hutscape/capsicum/readme.md

# Capsicum

> 🫑 Retrofit a wired doorbell to add WiFi and make it smart 🔔

Visit [hutscape.com/capsicum](https://hutscape.com/capsicum) for more details.

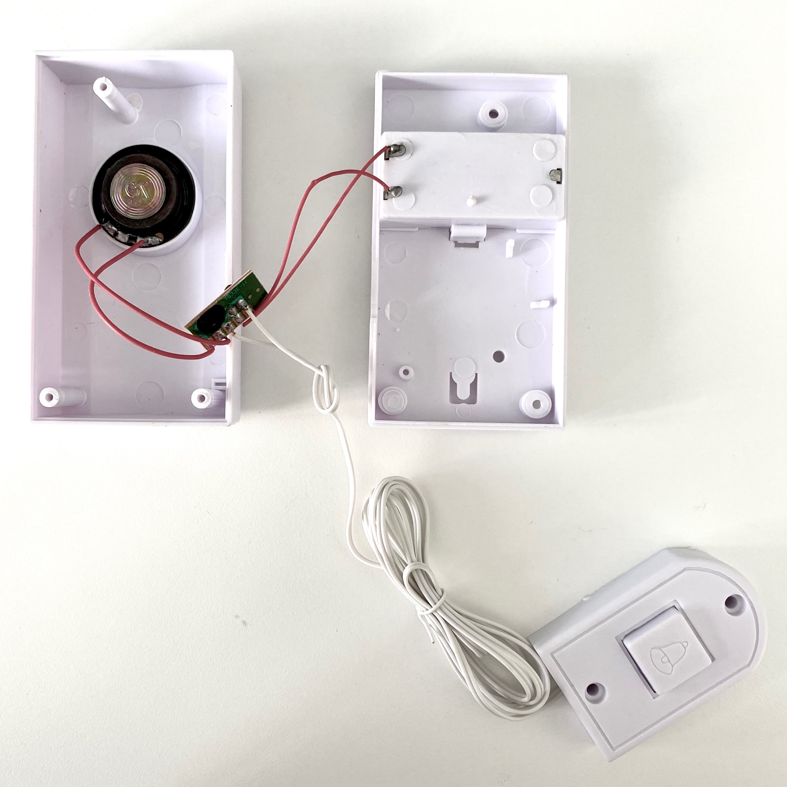
[picture p1: images/prototype/front.jpg]
