hutscape/capsicum/others.md

---
layout: others
title: Others
permalink: /others
sequence: 6

# Lessons
lessons:
  - title: V2.0
    subtitle: For next iteration
    list:
      - name: Use <a href="https://docs.kicad.org/8.0/en/pcbnew/pcbnew.html">teardrops</a> in KiCAD 8.0
      - name: Add <a href="https://youtu.be/g4m91gv-4oQ?t=1088">fudicial markers</a> for pick and place
      - name: Add more rounded corners and chamfers for <a href="https://www.pinterest.com/sayanee/product-design/">timeless product design</a> enclosures
      - name: Use a <a hreaf="https://github.com/makermoekoe/Picoclick-C3/blob/main/pcb/Picoclick_C3T/picoclick_c3t_v1_bom.csv#L18">single RGB LED</a> for status indication
      - name: Add <a href="https://forum.kicad.info/t/understanding-multi-sheet-schematics/42922/2">multi sheet schematics</a> for better readability
      - name: Add component images and parameter graphs<a href="https://github.com/EPFLXplore/XRE_LeggedRobot_HW/blob/master/amulet_controller/Schematic/amulet_controller.pdf"</a> in schematics
      - name: Use <a href="https://github.com/arduino-libraries/Arduino_ESP32_OTA">OTA updates</a> for firmware
      - name: Use a better quality <a href="https://www.digikey.com/en/products/detail/nidec-components-corporation/CL-SB-22A-11T/3507836">slide switch DPDT</a> for <a href="https://www.nordicsemi.com/Products/Development-hardware/Power-Profiler-Kit-2/Download#infotabs">better tactile feedback</a>

  - title: Lessons learnt
    subtitle: Improvements for the next version
    list:
      - name: <strong>Case</strong> - Make the text height bigger for LEDs and ON/OFF power switch
      - name: <strong>Case</strong> - Add more chamfers and rounded corners for a better aesthetic
      - name: <strong>Teeth and groves</strong> - Make the teeth thicker for better strength
      - name: <strong>Teeth and groves</strong> - Add holder in the teeth to that the top and bottom case do not slide
      - name: <strong>Teeth and grooves</strong> - Include visual cues on the exterior for finger placement
      - name: <strong>Battery</strong> - Use flat LiPo battery for a compact design
      - name: <strong>PCB</strong> - Add silkscreen pin labels for all connectors that extend outside the PCB E.g. pin headers or USB-C

# References
similar:
  - name: Adafruit QT Py ESP32-C3 WiFi Dev Board
    url: https://www.adafruit.com/product/5405
    type: maker
    year: 2022
    components:
      - type: module
        name: ESP32-C3H4 (no antenna)
      - type: LDO
        name: AP2112K-3.3
      - type: connector
        name: USB-C
  - name: Seeed Studio ESP32-C3 XIAO board
    url: https://files.seeedstudio.com/wiki/XIAO_WiFi/Resources/Seeeduino-XIAO-ESP32C3-SCH.pdf
    type: maker
    year: 2022
    components:
      - type: module
        name: ESP32-C3FN4 (no on-board antenna)
      - type: LDO
        name: XC6204B33
      - type: connector
        name: USB-C
  - name: Olimex ESP32-C3-DevKit-Lipo
    url: https://www.olimex.com/Products/IoT/ESP32-C3/ESP32-C3-DevKit-Lipo/open-source-hardware
    type: maker
    year: 2022
    components:
      - type: module
        name: ESP32-C3-MINI-1-N4 (with PCB antenna and 4MB flash)
      - type: DC-DC regulator
        name: SY8089AAAC
      - type: linear charger for lithium-ion batteries
        name: BL4054B
      - type: connector
        name: USB-C
      - type: battery
        name: LiPo
  - name: LilyGO T-OI Plus
    url: https://www.lilygo.cc/products/t-oi-plus
    type: maker
    year: 2021
    components:
      - type: module
        name: ESP32-C3
      - type: flash
        name: W25Q32FVSS (external 32MB flash)
      - type: LDO
        name: ME6211
      - type: linear charger for lithium-ion batteries
        name: TP4054
      - type: battery
        name: 16340
      - type: connector
        name: USB-C
  - name: Espressif ESP32-C3 DevKit M-1
    url: https://dl.espressif.com/dl/schematics/SCH_ESP32-C3-DEVKITM-1_V1_20200915A.pdf
    type: maker
    year: 2021
    components:
      - type: module
        name: ESP32-C3
      - type: connector
        name: micro USB
  - name: MakerMoeKoe picoclick C3
    url: https://github.com/makermoekoe/Picoclick-C3/blob/main/pcb/Picoclick_C3/picoclick_c3_v1.1.pdf
    type: maker
    year: 2021
    components:
      - type: module
        name: ESP32-C3
      - type: connector
        name: USB-C
  - name: DIY Wireless Smart Doorbell by The Hook Up
    url: https://github.com/thehookup/Wireless_MQTT_Doorbell
    type: maker
    year: 2018
    components:
      - type: module
        name: nodeMCU
      - type: software stack
        name: Node-Red, MQTT
  - name: SS4H-SD Smart Doorbell
    url: https://smartsolutions4home.com/ss4h-sd-smart-doorbell/
    type: maker
    year: 2020
    components:
      - type: module
        name: ESP32
      - type: software stack
        name: ESPHome, Home Assistant
  - name: Doorbell WiFi Upgrade
    url: https://www.youtube.com/watch?v=NP7_cPEDocI
    type: maker
    year: 2021
    components:
      - type: module
        name: ESP8266
      - type: software stack
        name: Node-Red, WLED
  - name: DIY Doorbell Circuit for Homes
    url: https://www.circuits-diy.com/diy-doorbell-circuit-for-homes-electronics-projects/
    type: maker
    year: 2022
    components:
      - type: melody generator IC
        name: UM66
      - type: speaker
        name: 8ohms speaker
  - name: Prototype to PCB by Using Autodesk Circuits
    url: https://www.instructables.com/Prototype-to-PCB-by-Using-Autodesk-Circuits/
    type: maker
    year: 2016
    components:
      - type: melody generator IC
        name: NE555N
      - type: speaker
        name: 8ohms speaker
  - name:  DIY Musical Doorbell Circuit using UM66T
    url: https://circuitdigest.com/electronic-circuits/diy-musical-doorbell-circuit-using-um66-ic
    type: maker
    year: 2021
    components:
      - type: speaker
        name: 8ohms speaker
      - type: melody generator IC
        name: UM66T
  - name: Electronic ding dong doorbell
    url: https://www.pcbway.com/project/shareproject/Electronic_ding_dong_doorbell.html
    type: maker
    year: 2020
    components:
      - type: speaker
        name: 8ohms speaker
      - type: melody generator IC
        name: IC555

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

  - topic: Snap fit 3D printed enclosure
    list:
      - name: Adafruit Feather Scorpio Snap Fit Case
        url: https://learn.adafruit.com/feather-scorpio-snap-fit-case/overview
      - name: No-screw PCB placement in a snap fit 3D printed case
        url: https://www.youtube.com/watch?v=m_-d8xcSDQs
      - name: Simple SNAP FIT ENCLOSURE Design
        url: https://www.youtube.com/watch?v=EPpr1nilC14

  - topic: ESP32
    list:
      - name: Espressif product comparison
        url: https://products.espressif.com/#/product-comparison

  - topic: Low Power battery measurement circuit
    list:
      - name: Battery Voltage Monitoring
        url: https://electronics.stackexchange.com/questions/424627/battery-voltage-monitoring
      - name: Zero-power battery measurement
        url: https://jeelabs.org/2013/05/17/zero-powe-battery-measurement/index.html
      - name: Low Power battery measurement switch?
        url: https://forum.arduino.cc/t/low-power-battery-measurement-switch/1171203

# Schedule
design_start: '2023-10-01'
design_end: '2024-02-29'
manufacturing_start: '2024-03-01'
manufacturing_end: '2024-03-21'
manufacturing_end: '2024-03-21'
integration_start: '2024-03-22'
progress:
  - month: March 2024
    details: Send for manufacturing and assembly of 2 prototypes. This phase includes PCB manufacturing, component procurement, pick and place, 3D printing the cases.
  - month: December 2023
    details: Completing the schematics with footprints, MPN and availability of assembly parts.
---
