hutscape/capsicum/_code/only-breadboard.md

---
layout: code
title: Only breadboard with PSU
description: Test the retrofit of the doorbell with only the breadboard and a PSU
difficulty: easy
features:
  - retrofit
  - push
  - button
  - power supply unit
  - psu
  - bell
has_code: false
images:
  prototype: only-breadboard-prototype.jpeg
  schematic: only-breadboard-schematic.png
---

This example shows how to test the retrofit of the doorbell with only the breadboard and a PSU providing 3.3V. The breadboard is used to connect the push button and the retrofit board. The PSU is used to provide power to the retrofit board.
