hutscape/capsicum/images/case/case-3dprint-3.jpg

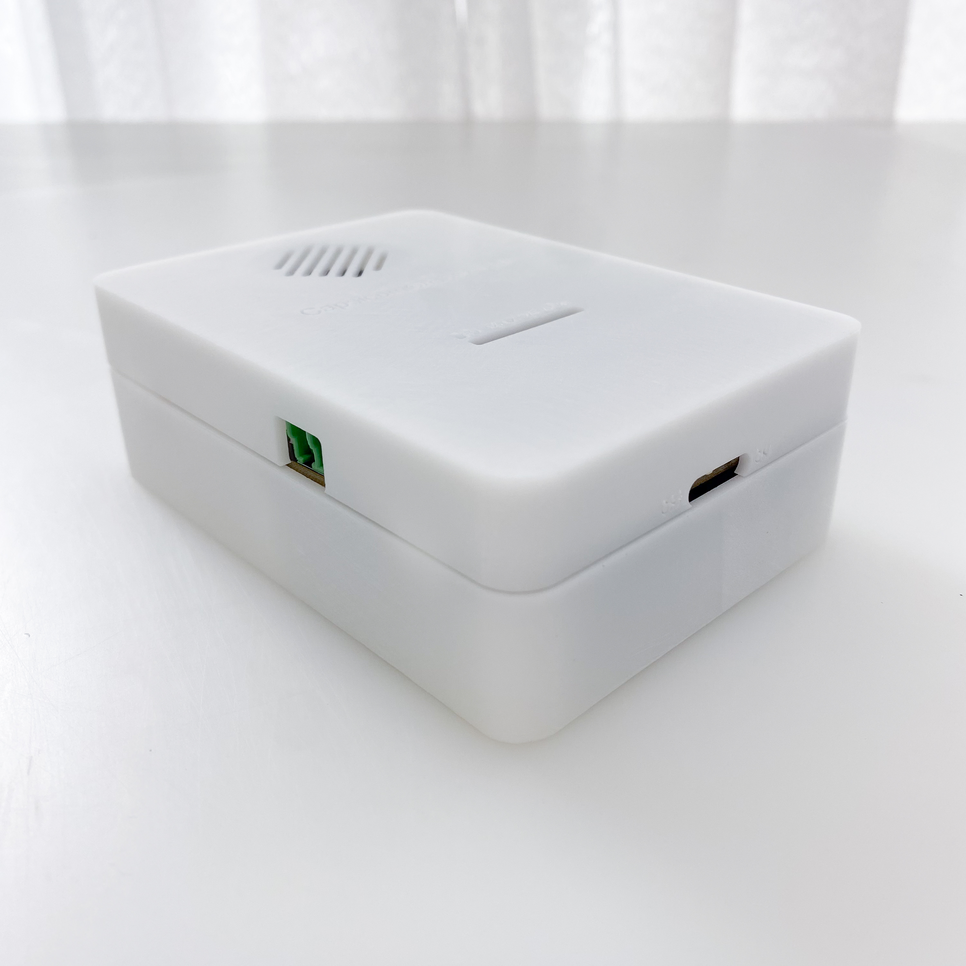
images/case/case-3dprint-3.jpg
