hutscape/capsicum/images/case/case-back.png

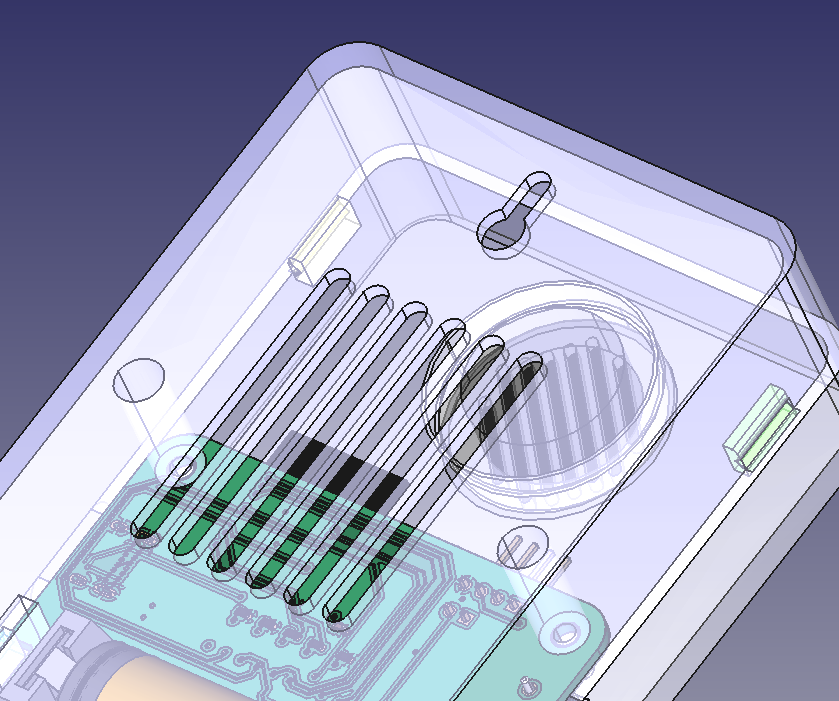
images/case/case-back.png
