hutscape/capsicum/images/case/case-details-1.png

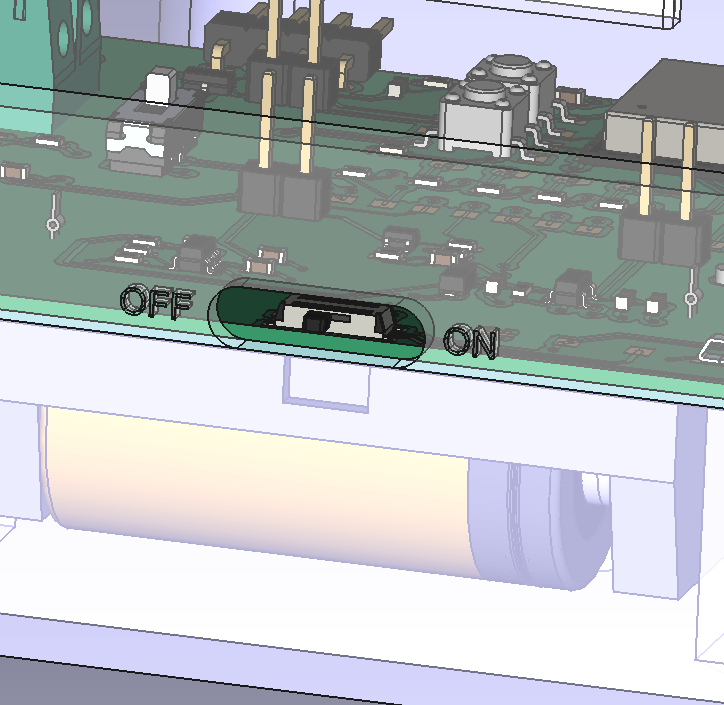
images/case/case-details-1.png
