hutscape/capsicum/images/case/case-details-2.png

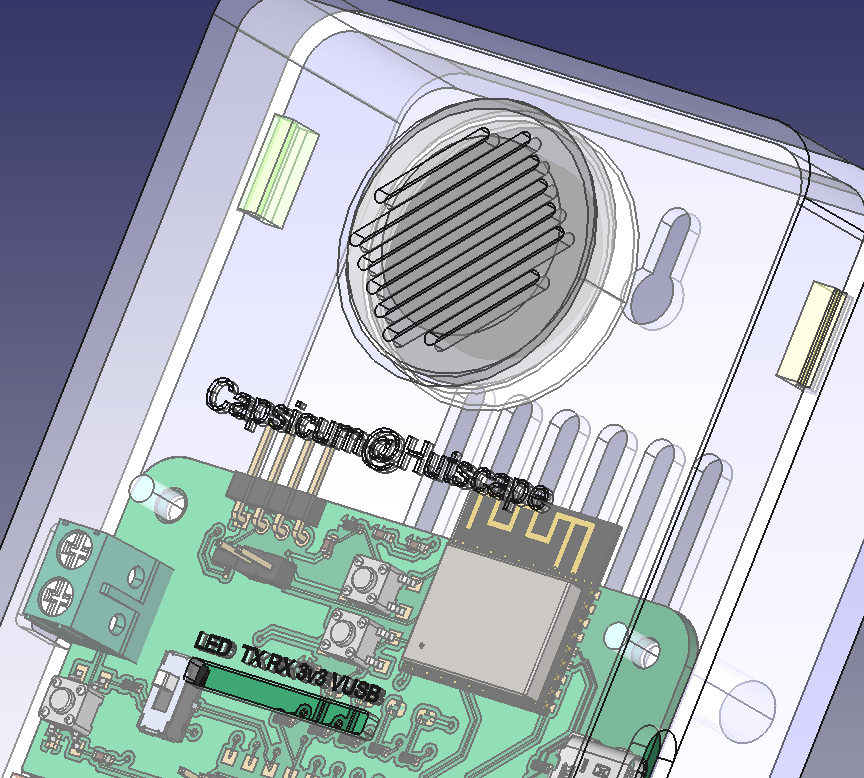
images/case/case-details-2.png
