hutscape/capsicum/images/case/case-electronics.png

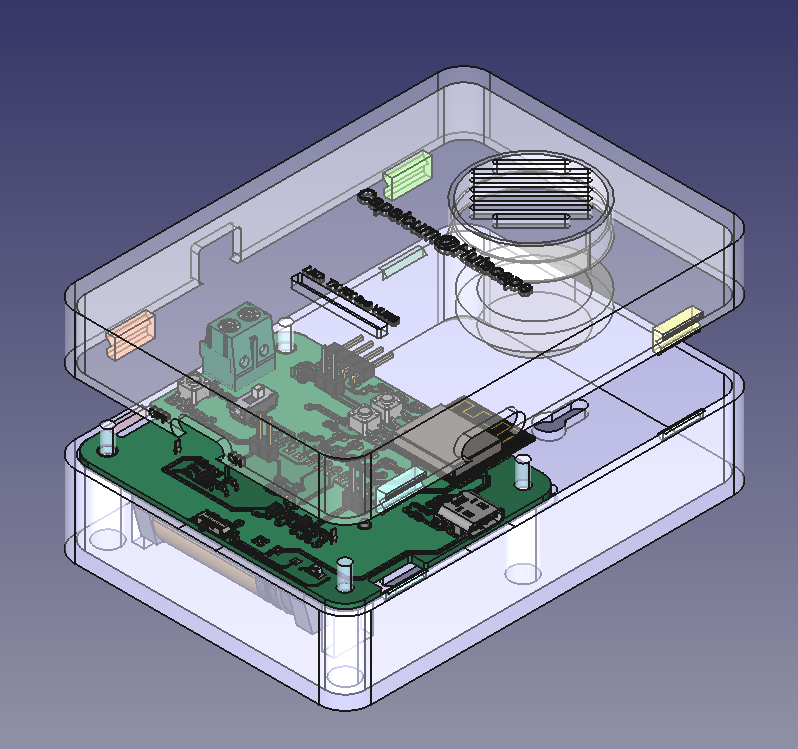
images/case/case-electronics.png
