hutscape/capsicum/images/case/case-front.png

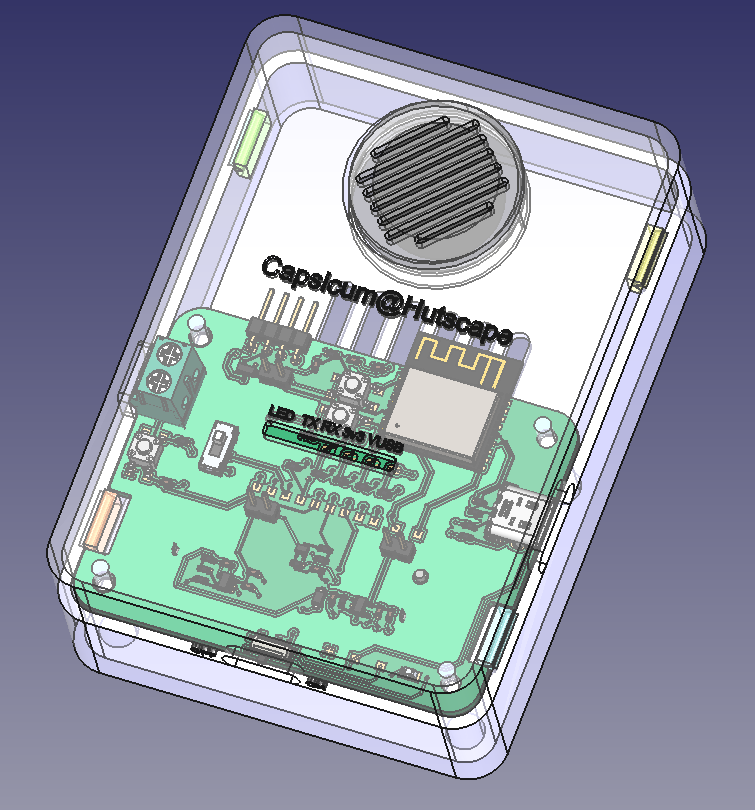
images/case/case-front.png
