hutscape/capsicum/images/case/case.png

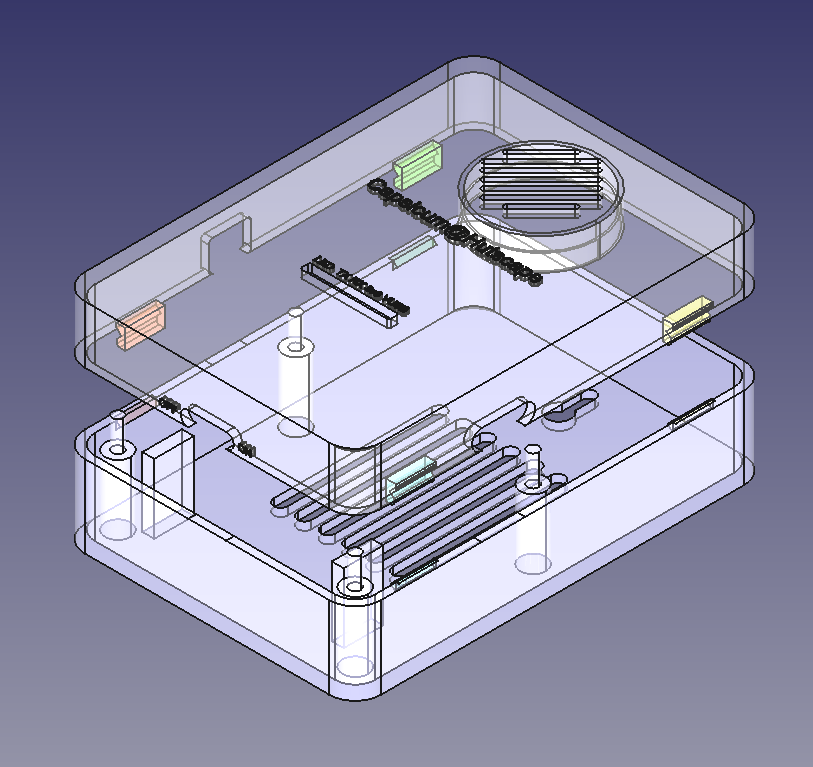
images/case/case.png
