hutscape/capsicum/images/code/access-point-console.png

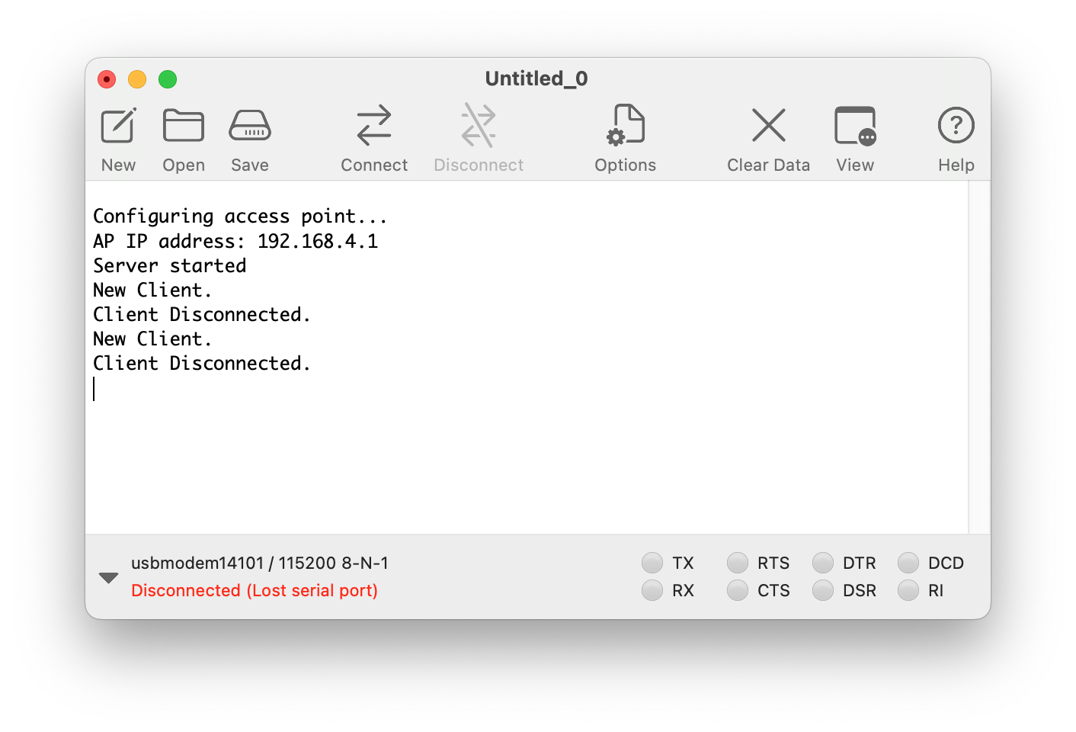
images/code/access-point-console.png
