hutscape/capsicum/images/code/access-point-prototype.jpg

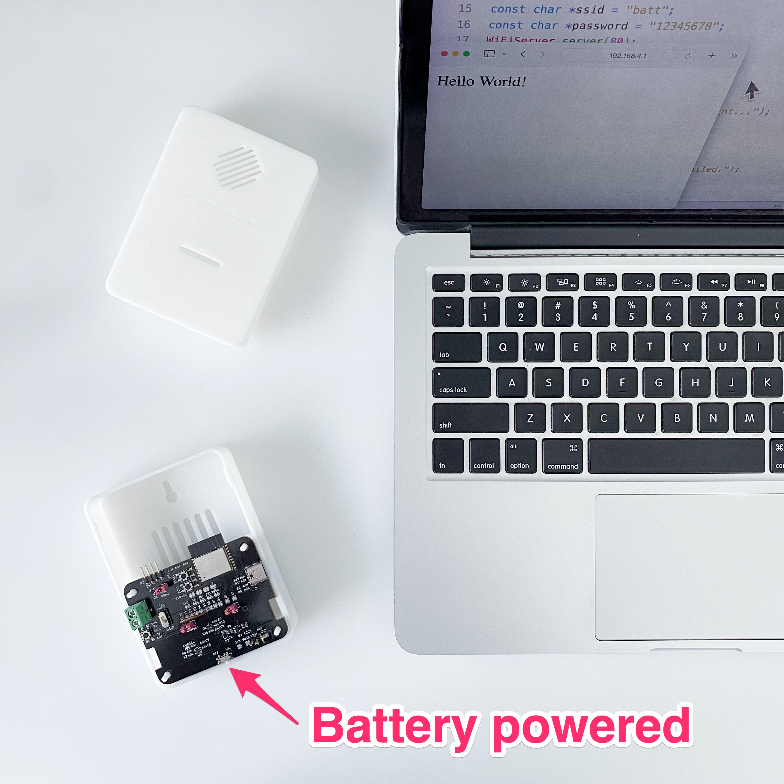
images/code/access-point-prototype.jpg
