hutscape/capsicum/images/code/analog-battery-adc-console.png

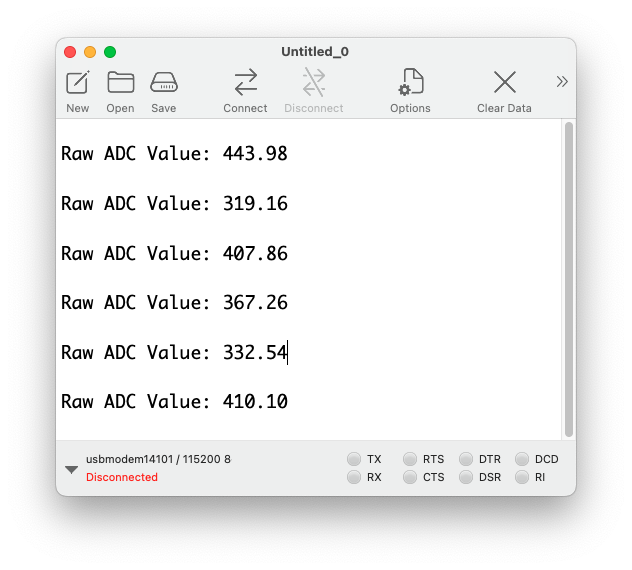
images/code/analog-battery-adc-console.png
