hutscape/capsicum/images/code/analog-battery-adc-prototype.jpeg

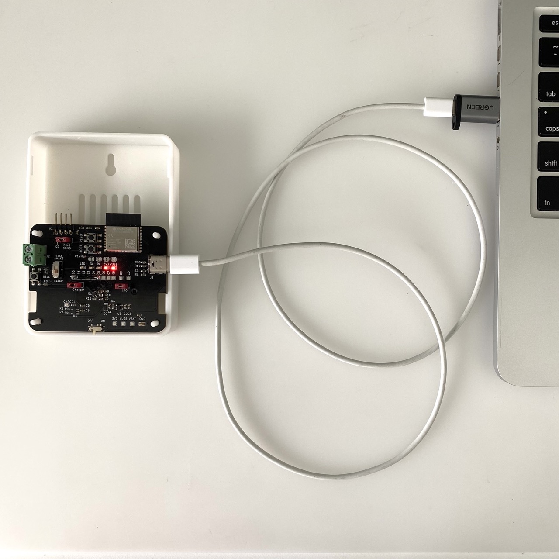
images/code/analog-battery-adc-prototype.jpeg
