hutscape/capsicum/images/code/blinky-console.png

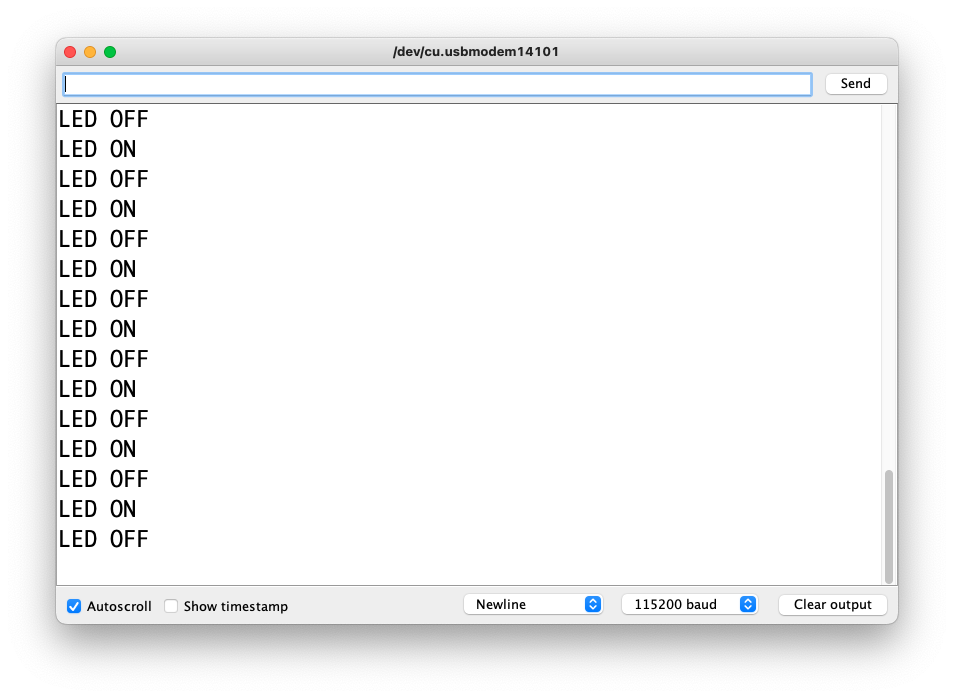
images/code/blinky-console.png
