hutscape/capsicum/images/code/blinky-prototype.jpg

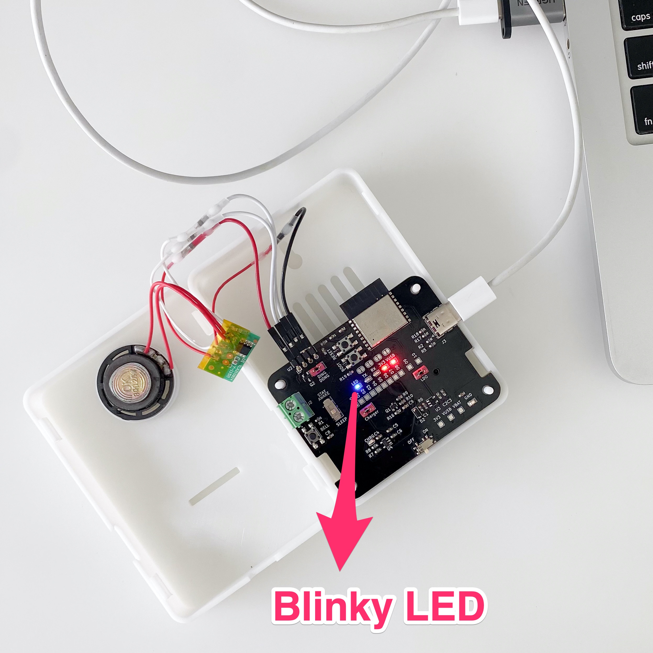
images/code/blinky-prototype.jpg
