hutscape/capsicum/images/code/demo-breadboard-console.png

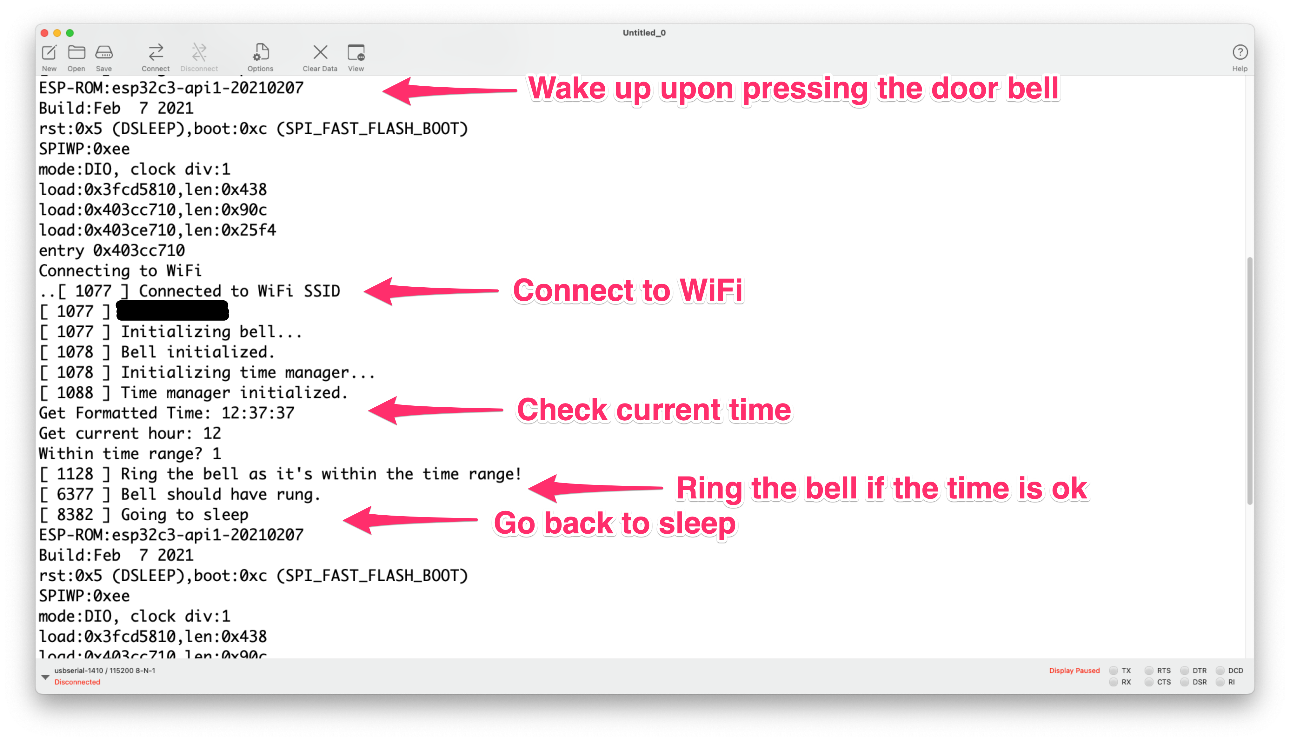
images/code/demo-breadboard-console.png
