hutscape/capsicum/images/code/demo-breadboard-schematic.png

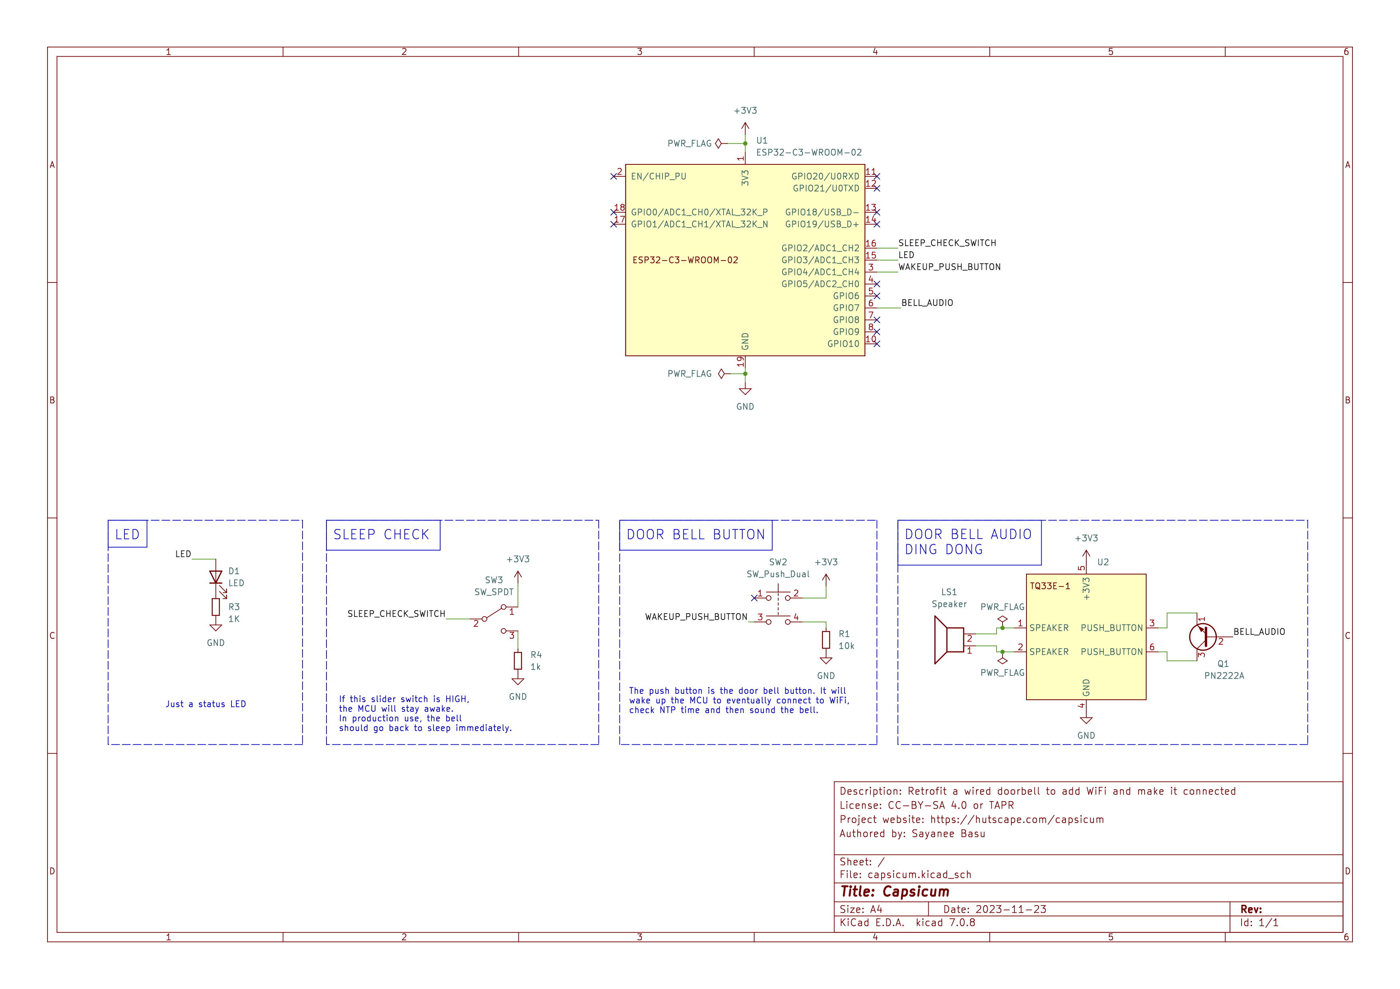
images/code/demo-breadboard-schematic.png
