hutscape/capsicum/images/code/demo-prototype.jpg

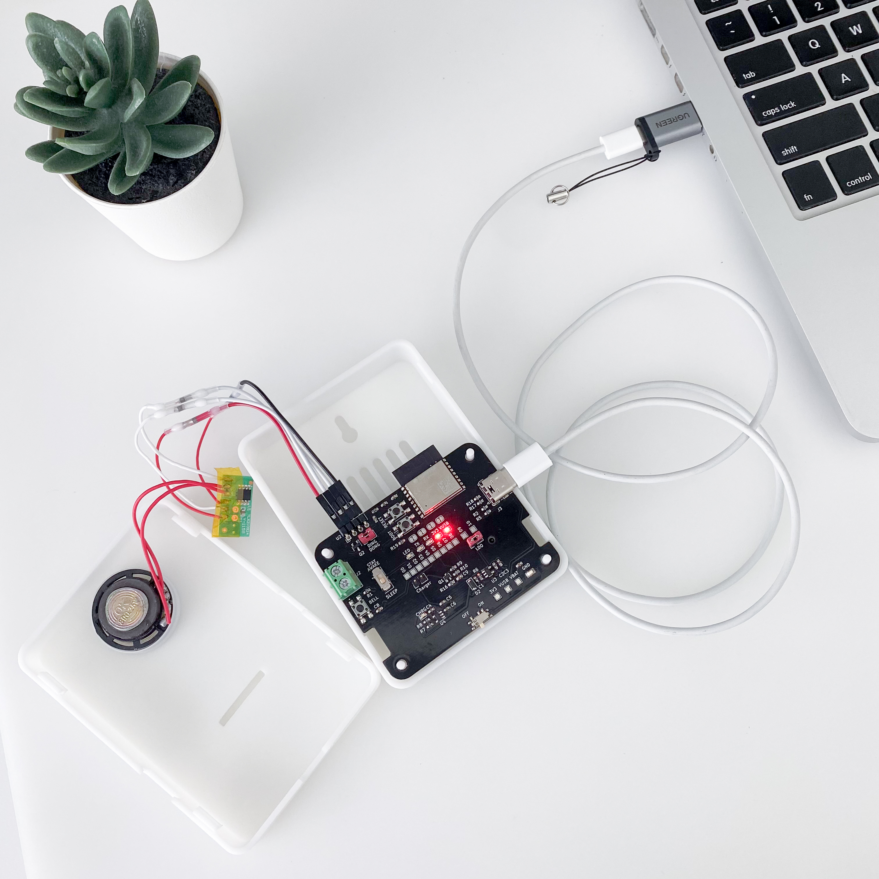
images/code/demo-prototype.jpg
