hutscape/capsicum/images/code/minimum-breadboard-prototype.jpg

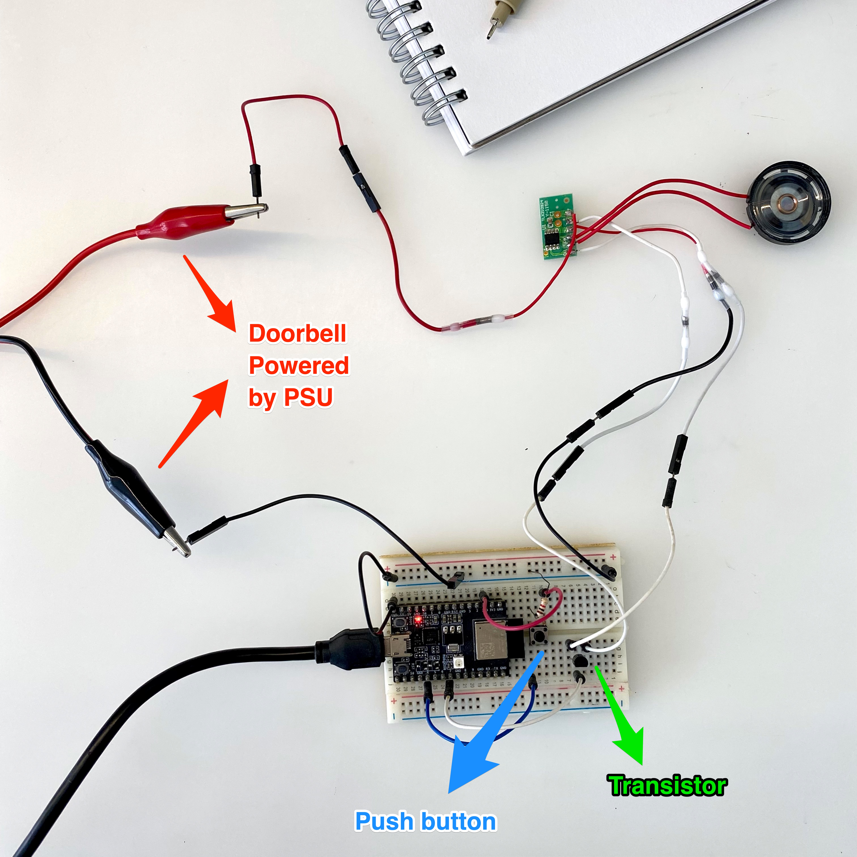
images/code/minimum-breadboard-prototype.jpg
