hutscape/capsicum/images/code/minimum-breadboard-schematic.png

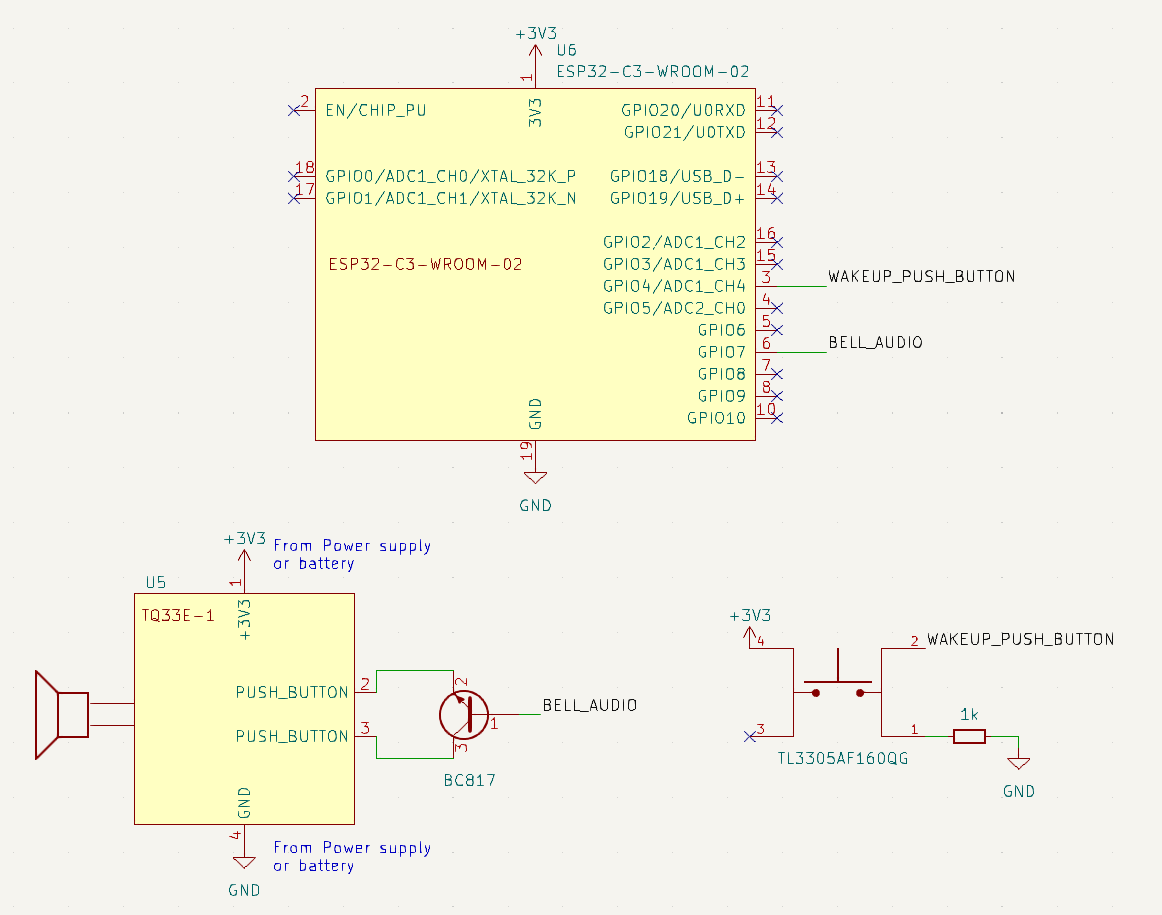
images/code/minimum-breadboard-schematic.png
