hutscape/capsicum/images/code/minumum-breadboard-console.png

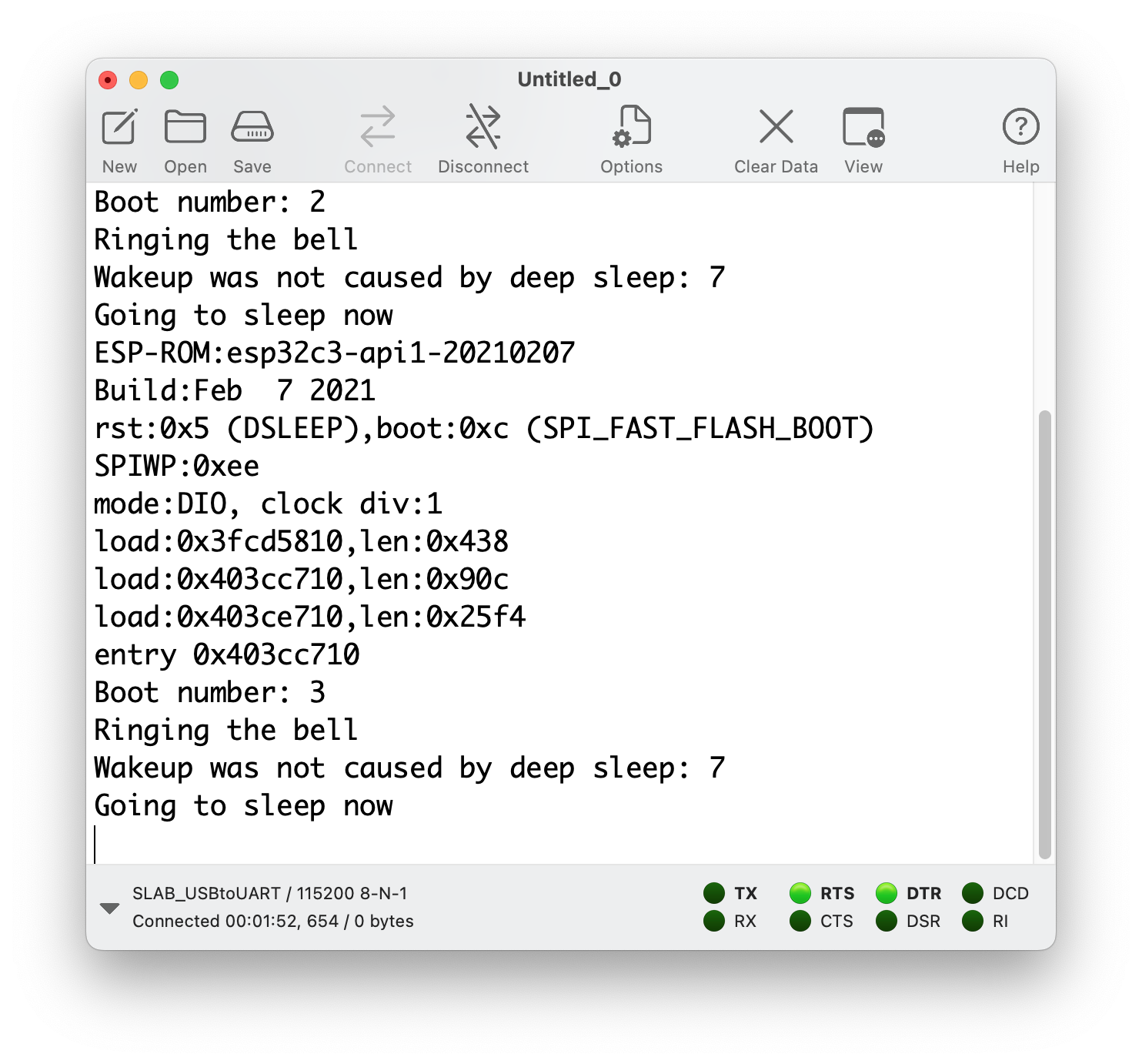
images/code/minumum-breadboard-console.png
