hutscape/capsicum/images/code/only-breadboard-prototype.jpeg

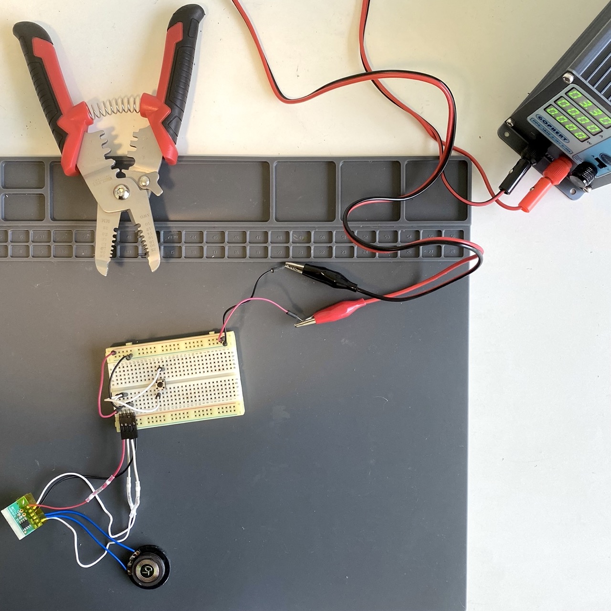
images/code/only-breadboard-prototype.jpeg
