hutscape/capsicum/images/code/only-breadboard-schematic.png

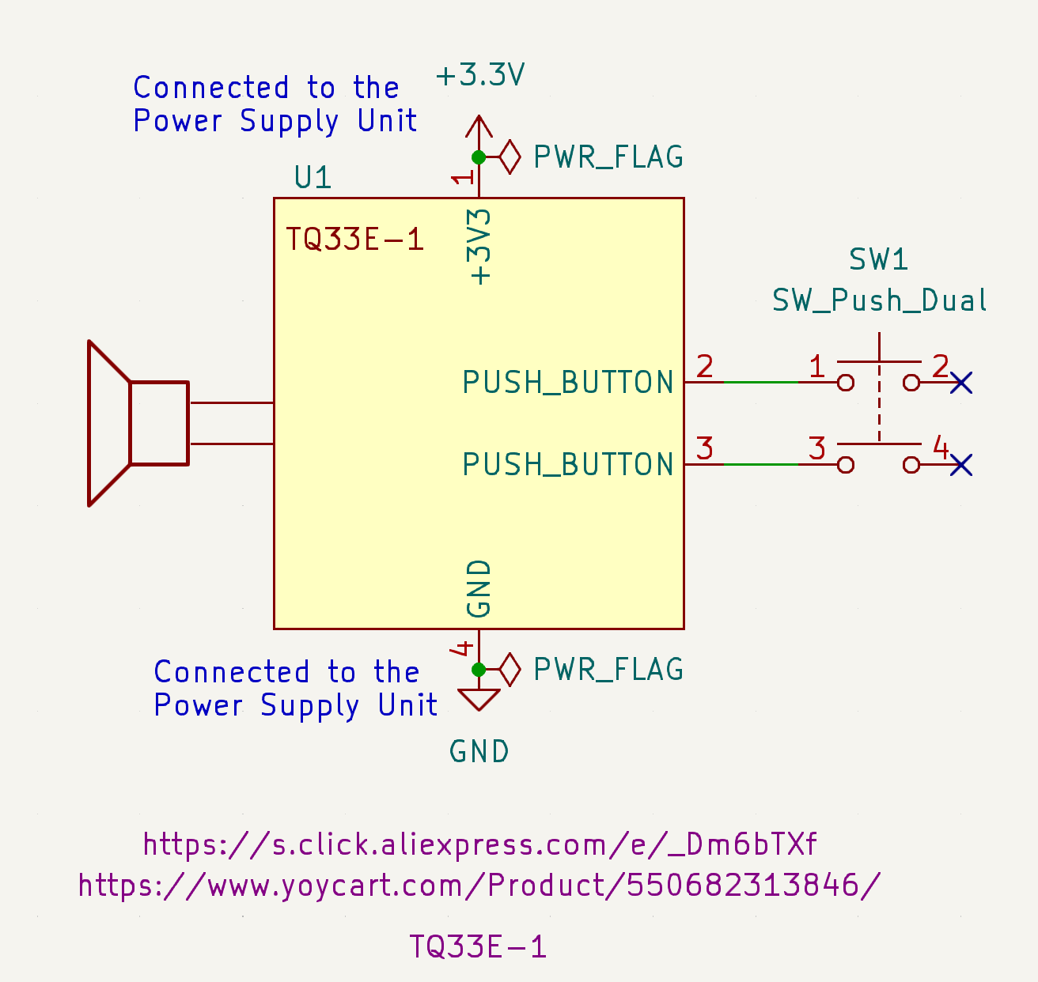
images/code/only-breadboard-schematic.png
