hutscape/capsicum/images/code/schematic.png

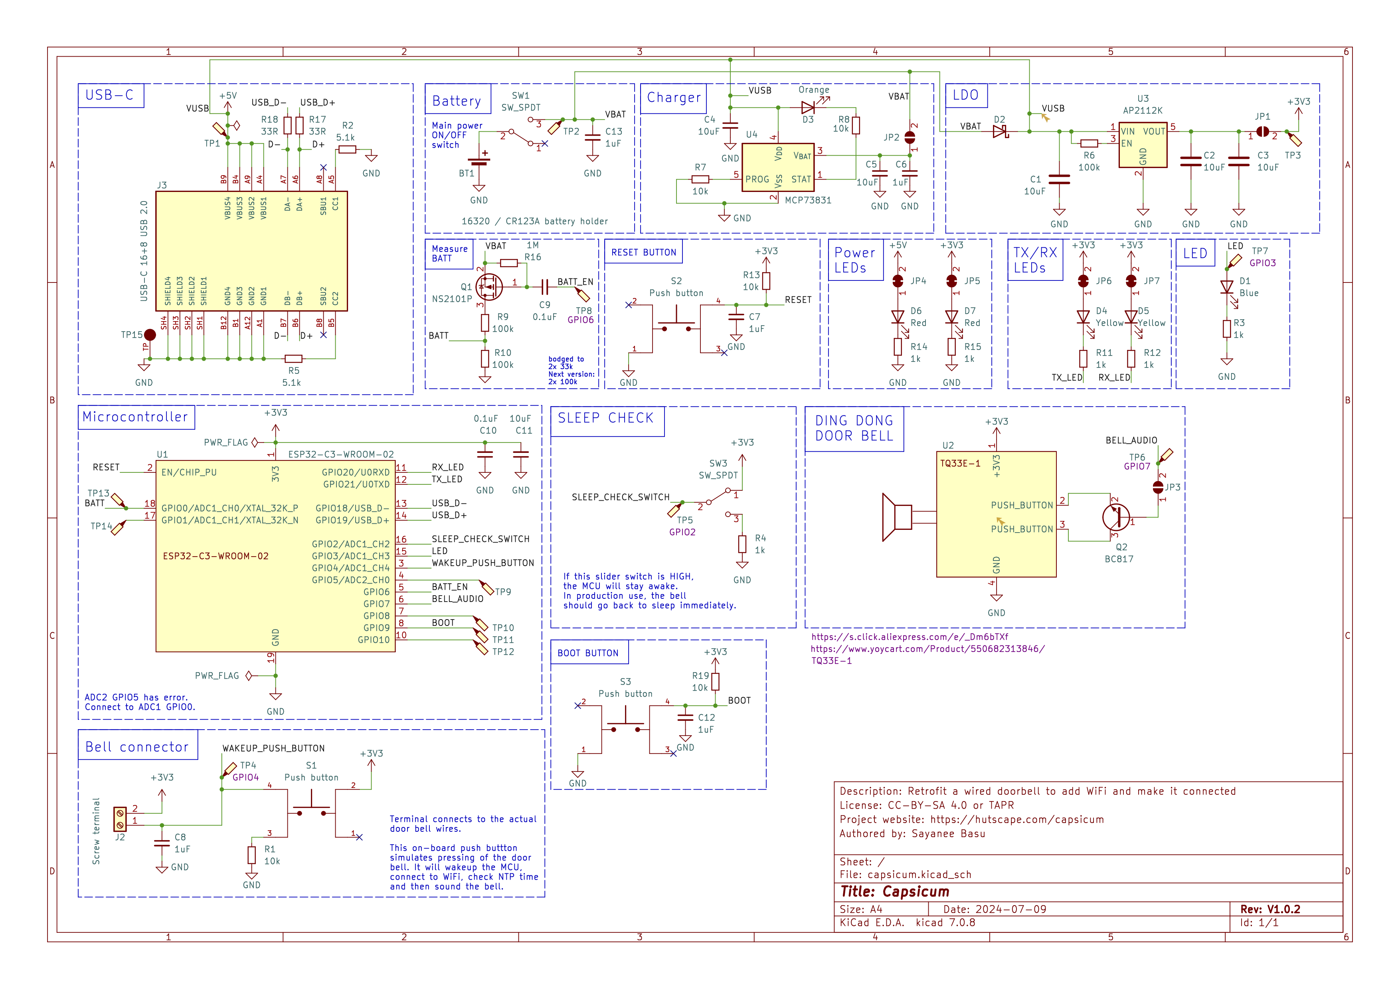
images/code/schematic.png
