hutscape/capsicum/images/design/subsystem.png

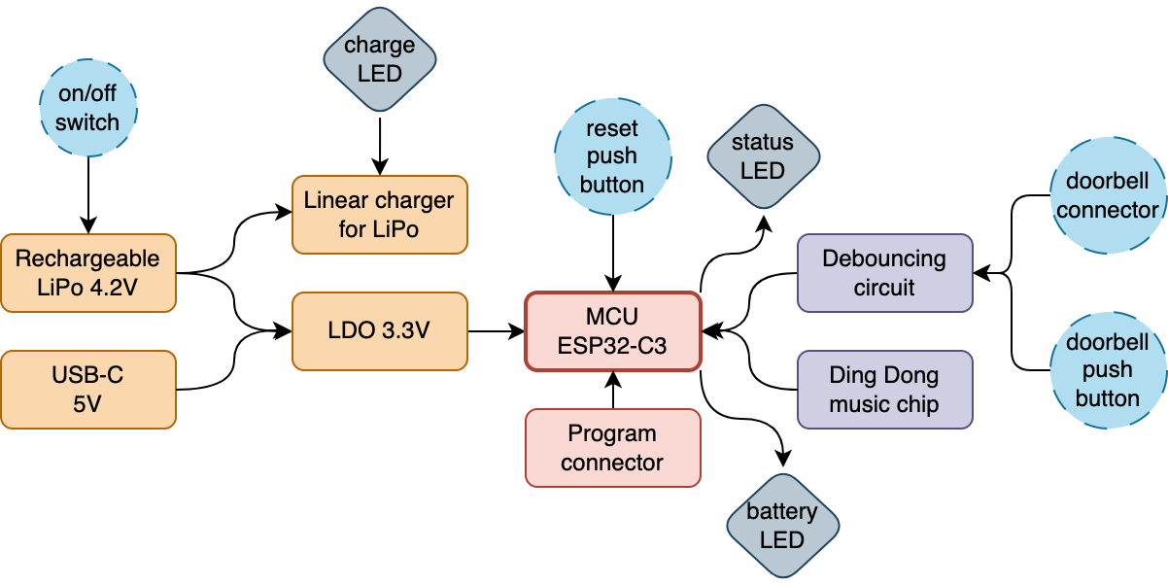
images/design/subsystem.png
