hutscape/capsicum/images/pcb/3dview-bottom.png

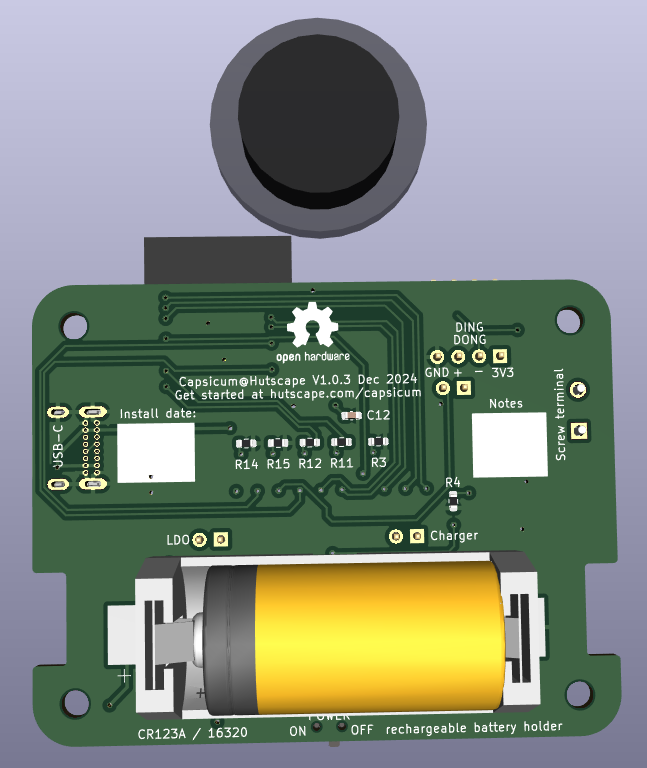
images/pcb/3dview-bottom.png
