hutscape/capsicum/images/pcb/3dview-top.png

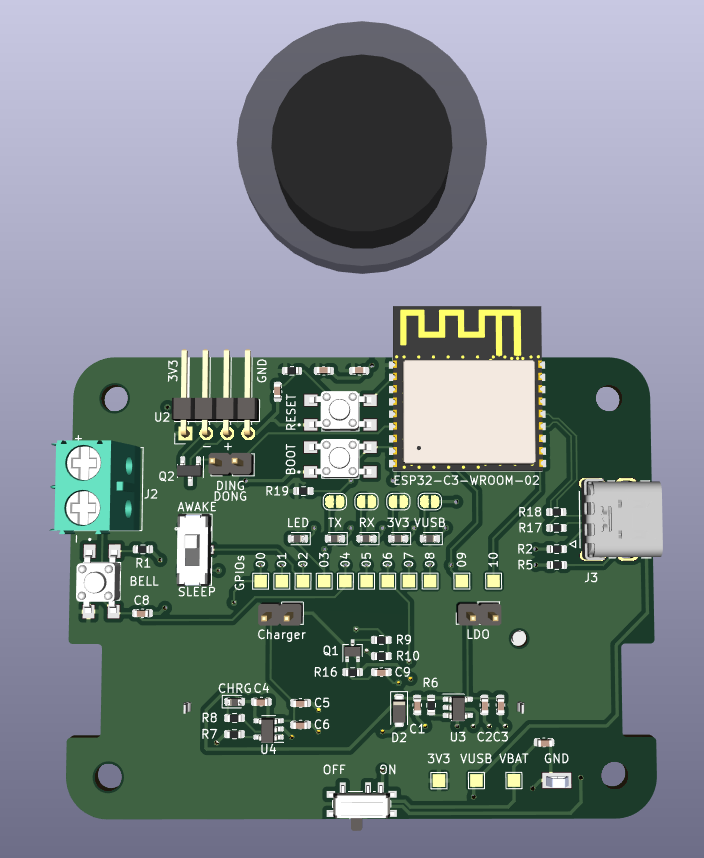
images/pcb/3dview-top.png
