hutscape/capsicum/images/pcb/back.jpg

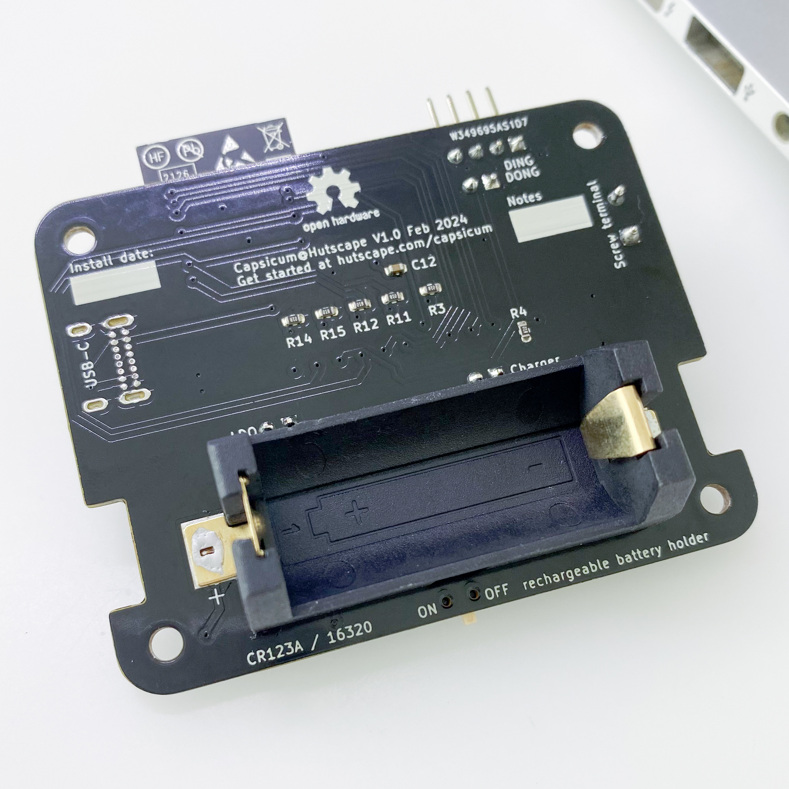
images/pcb/back.jpg
