hutscape/capsicum/images/pcb/front.jpg

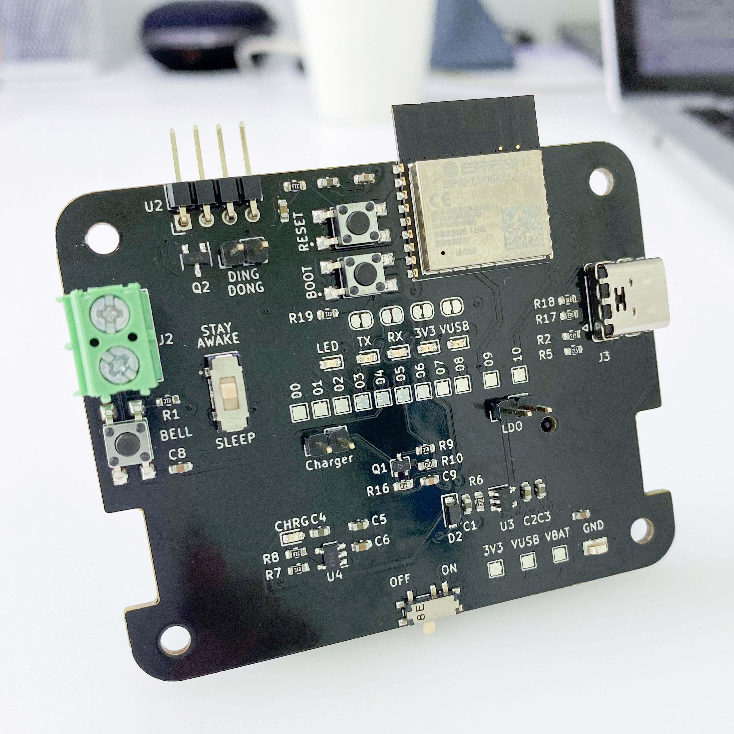
images/pcb/front.jpg
