hutscape/capsicum/images/pcb/pcbway.png

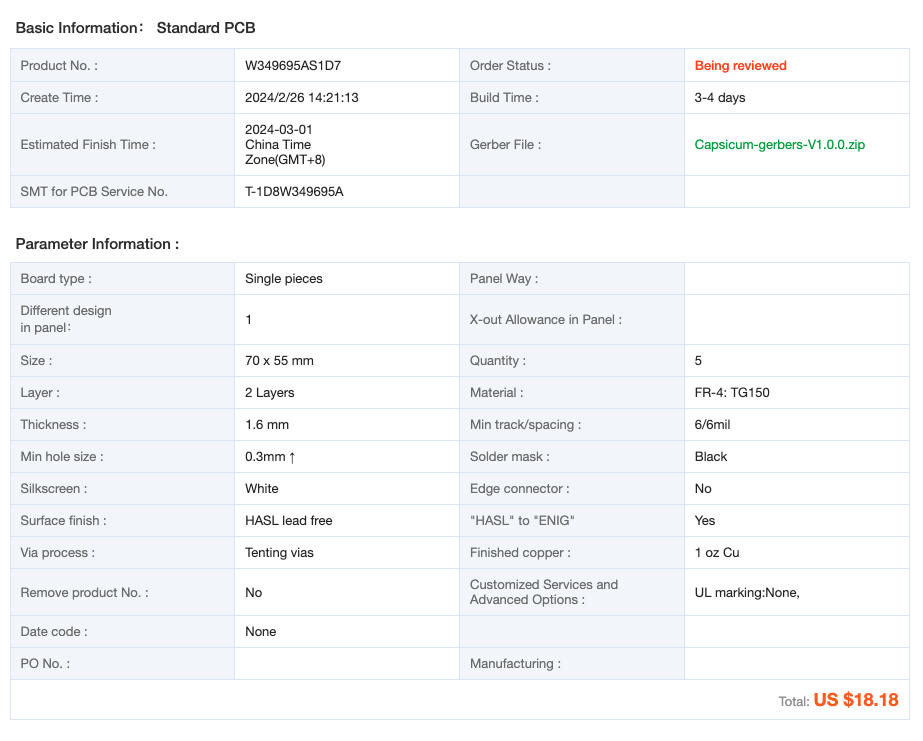
images/pcb/pcbway.png
