hutscape/capsicum/images/prototype/initial-doorbell-chip-back.jpg

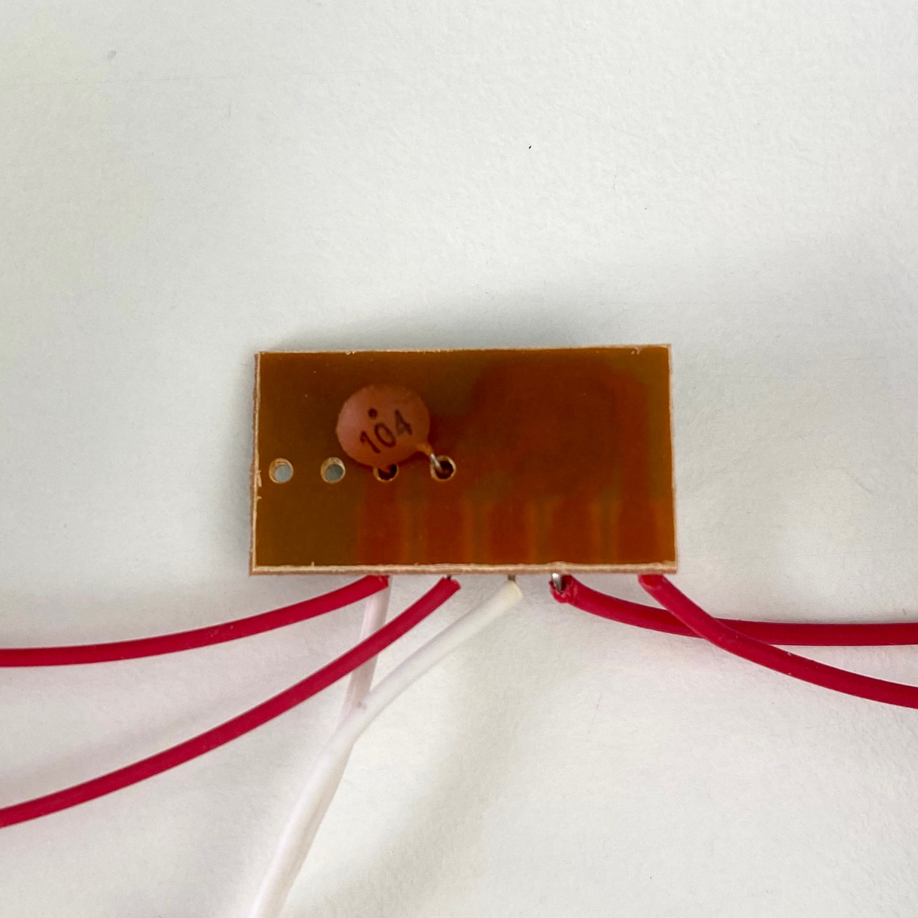
images/prototype/initial-doorbell-chip-back.jpg
