hutscape/capsicum/images/prototype/initial-doorbell-chip.jpg

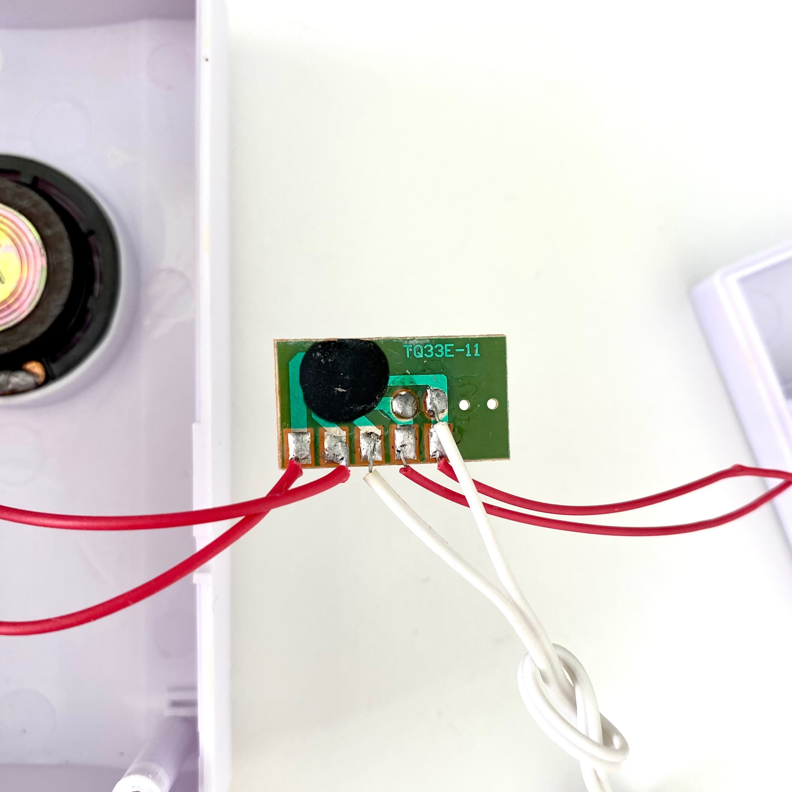
images/prototype/initial-doorbell-chip.jpg
