hutscape/capsicum/images/prototype/initial-doorbell.jpg

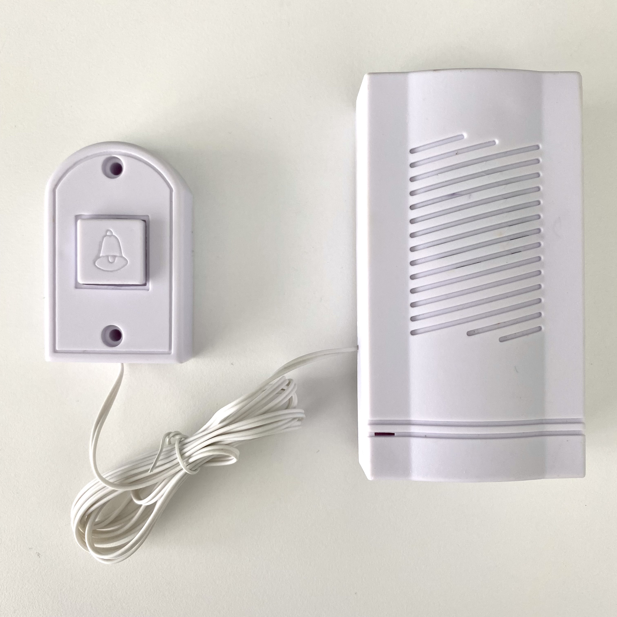
images/prototype/initial-doorbell.jpg
