hutscape/capsicum/images/prototype/prototype-6.jpg

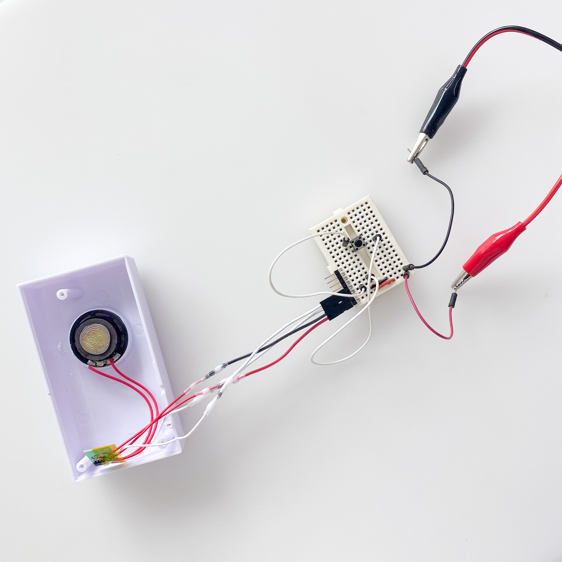
images/prototype/prototype-6.jpg
