hutscape/capsicum/images/prototype/prototype-7.jpg

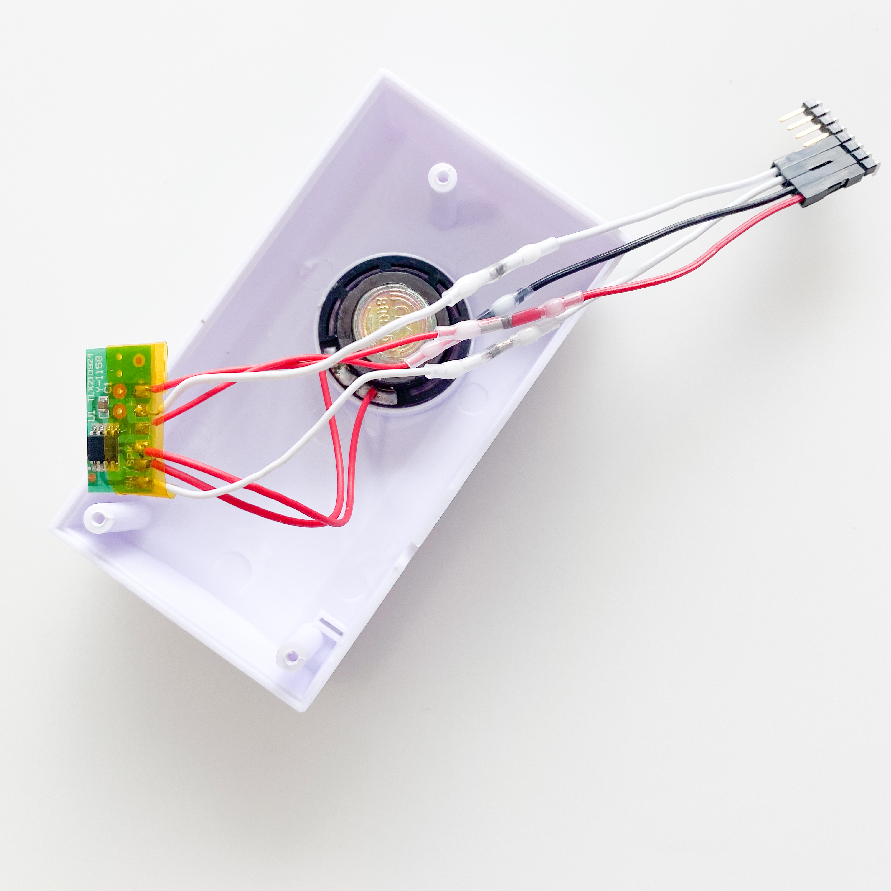
images/prototype/prototype-7.jpg
