hutscape/capsicum/images/prototype/prototype-8.jpg

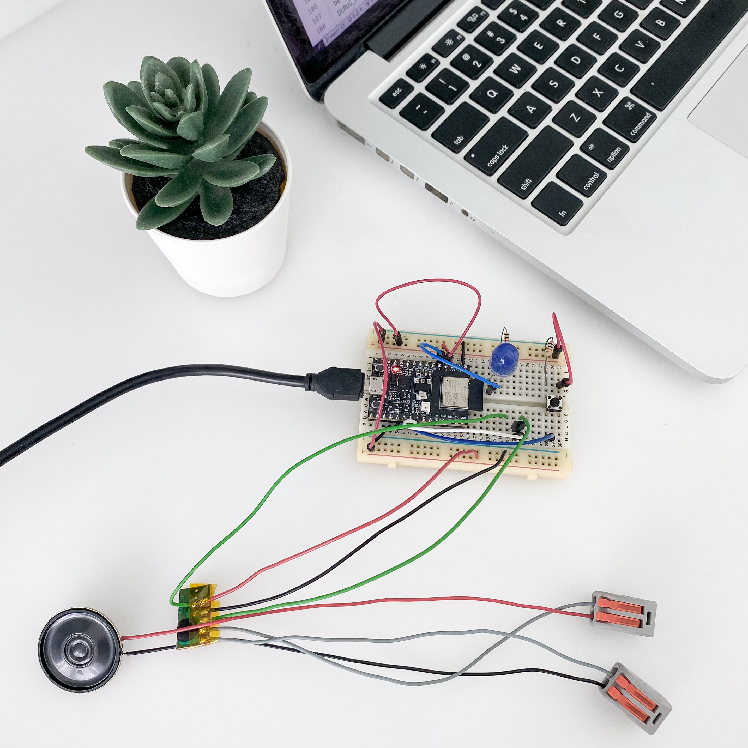
images/prototype/prototype-8.jpg
