hutscape/capsicum/_data/cost.csv

Task | Cost (USD) per unit | Qty | Total (USD)
PCB | $3.64 | 5 | $18.18
Components | $20.62 | 2 | $41.24
Assembly | $15.00 | 2 | $30.00
Case | $10.71 | 2 | $21.41
Shipping |  |  | $11.78
TOTAL | $49.96 | 2 | $122.61
