hutscape/capsicum/case/case.FCStd

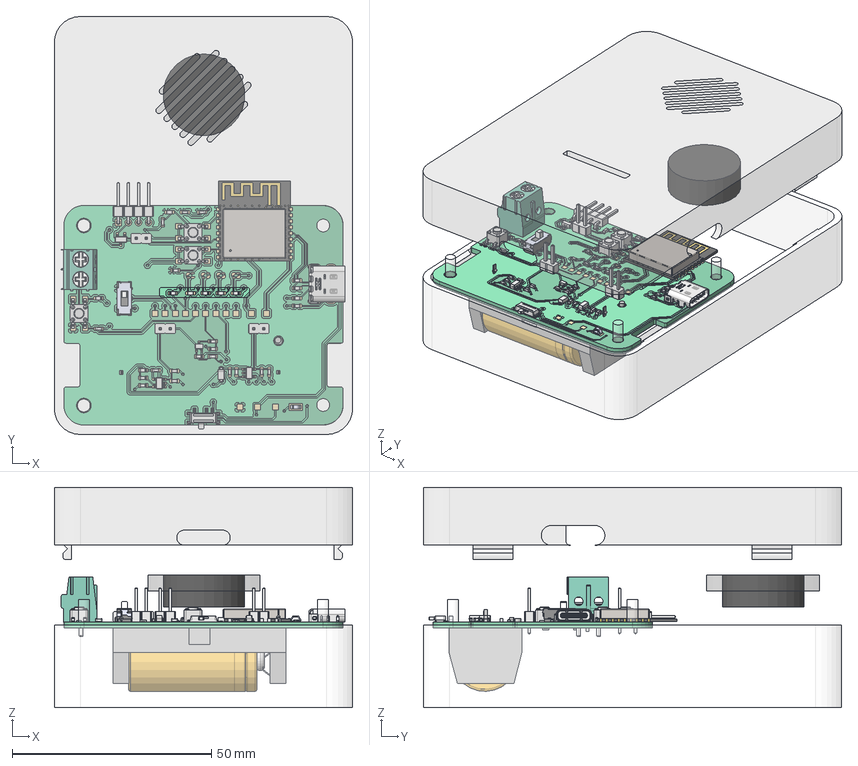
[picture p58: CAD file, 2024-02-01]
case/case.FCStd
74.8 x 104.8 x 55.2 mm
bottom001
top001
Pcb_da47
topPads_da47
topTracks_da47
topZones_da47
botPads_da47
botTracks_da47
botZones_da47
R19_R_0603_1608Metric_5c25c1aa4b16 x 25
JP3_PinHeader_1x02_P254mm_Vertical_043b86013d76 x 3
JS102011JCQN
JS102011JCQN001
JS102011JCQN002
JS102011JCQN003
JS102011JCQN004
JS102011JCQN005
JS102011JCQN006
JS102011JCQN007
JS102011JCQN008
Q2_SOT_23_577b748c5ad2
S2_P:\E-Switch Secure\3D_MODELS_STP_FORMAT\TL3305AFxxxxG.stp_a5b8d5e37aa4 x 3
C9_C_0603_1608Metric_c013bc0dc619 x 12
SW1_Fusion_sp_55a2974d3716
TP15_5015_7eae7c5f8810
Q1_SOT_323_SC_70_7a53a524a0a1
U2_PinHeader_1x04_P254mm_Horizontal_db5c724d04b4
D2_D_SOD_123F_35eaea926330
XTAL3225_20210301.STEP^XTAL3225_20210301.STEP_Submodel-XTAL3225_part_DesignRootModel_PCB_ESP32-C3-WROOM-02_V1(2)_PCB_ESP32-C3-WROOM-02_V1
XTAL3225_20210301.STEP^XTAL3225_20210301.STEP_Submodel-XTAL3225_part_DesignRootModel_PCB_ESP32-C3-WROOM-02_V1(2)_PCB_ESP32-C3-WROOM-02_V002
XTAL3225_20210301.STEP^XTAL3225_20210301.STEP_Submodel-XTAL3225_part_DesignRootModel_PCB_ESP32-C3-WROOM-02_V1(2)_PCB_ESP32-C3-WROOM-02_V003
XTAL3225_20210301.STEP^XTAL3225_20210301.STEP_Submodel-XTAL3225_part_DesignRootModel_PCB_ESP32-C3-WROOM-02_V1(2)_PCB_ESP32-C3-WROOM-02_V004
XTAL3225_20210301.STEP^XTAL3225_20210301.STEP_Submodel-XTAL3225_part_DesignRootModel_PCB_ESP32-C3-WROOM-02_V1(2)_PCB_ESP32-C3-WROOM-02_V005
ESP32-C3_20210301.STEP^ESP32-C3_20210301.STEP_Submodel-QFN32_0P5_5_B_part_DesignRootModel_PCB_ESP32-C3-WROOM-02_V1(2)_PCB_ESP32-C3-WROOM-02_V1
ESP32-C3_20210301.STEP^ESP32-C3_20210301.STEP_Submodel-QFN32_0P5_5_B_part_DesignRootModel_PCB_ESP32-C3-WROOM-02_V1(2)_PCB_ESP32-C3-WROOM-02_V002
SOIC8_208_20210301.STEP^SOIC8_208_20210301.STEP_Submodel-SOP8_1P27_6P6_part_DesignRootModel_PCB_ESP32-C3-WROOM-02_V1(2)_PCB_ESP32-C3-WROOM-02_V1
SOIC8_208_20210301.STEP^SOIC8_208_20210301.STEP_Submodel-SOP8_1P27_6P6_part_DesignRootModel_PCB_ESP32-C3-WROOM-02_V1(2)_PCB_ESP32-C3-WROOM-02_V002
SOIC8_208_20210301.STEP^SOIC8_208_20210301.STEP_Submodel-SOP8_1P27_6P6_part_DesignRootModel_PCB_ESP32-C3-WROOM-02_V1(2)_PCB_ESP32-C3-WROOM-02_V003
SOIC8_208_20210301.STEP^SOIC8_208_20210301.STEP_Submodel-SOP8_1P27_6P6_part_DesignRootModel_PCB_ESP32-C3-WROOM-02_V1(2)_PCB_ESP32-C3-WROOM-02_V004
SOIC8_208_20210301.STEP^SOIC8_208_20210301.STEP_Submodel-SOP8_1P27_6P6_part_DesignRootModel_PCB_ESP32-C3-WROOM-02_V1(2)_PCB_ESP32-C3-WROOM-02_V005
SOIC8_208_20210301.STEP^SOIC8_208_20210301.STEP_Submodel-SOP8_1P27_6P6_part_DesignRootModel_PCB_ESP32-C3-WROOM-02_V1(2)_PCB_ESP32-C3-WROOM-02_V006
SOIC8_208_20210301.STEP^SOIC8_208_20210301.STEP_Submodel-SOP8_1P27_6P6_part_DesignRootModel_PCB_ESP32-C3-WROOM-02_V1(2)_PCB_ESP32-C3-WROOM-02_V007
SOIC8_208_20210301.STEP^SOIC8_208_20210301.STEP_Submodel-SOP8_1P27_6P6_part_DesignRootModel_PCB_ESP32-C3-WROOM-02_V1(2)_PCB_ESP32-C3-WROOM-02_V008
SOIC8_208_20210301.STEP^SOIC8_208_20210301.STEP_Submodel-SOP8_1P27_6P6_part_DesignRootModel_PCB_ESP32-C3-WROOM-02_V1(2)_PCB_ESP32-C3-WROOM-02_V009
R0201_20210301.STEP^R0201_20210301.STEP_Submodel-R0201_part_DesignRootModel_PCB_ESP32-C3-WROOM-02_V1(2)_PCB_ESP32-C3-WROOM-02_V1
R0201_20210301.STEP^R0201_20210301.STEP_Submodel-R0201_part_DesignRootModel_PCB_ESP32-C3-WROOM-02_V1(2)_PCB_ESP32-C3-WROOM-02_V002
R0201_20210301.STEP^R0201_20210301.STEP_Submodel-R0201_part_DesignRootModel_PCB_ESP32-C3-WROOM-02_V1(2)_PCB_ESP32-C3-WROOM-02_V003
R0201_20210301.STEP^R0201_20210301.STEP_Submodel-R0201_part_DesignRootModel_PCB_ESP32-C3-WROOM-02_V1(2)_PCB_ESP32-C3-WROOM-02_V005
R0201_20210301.STEP^R0201_20210301.STEP_Submodel-R0201_part_DesignRootModel_PCB_ESP32-C3-WROOM-02_V1(2)_PCB_ESP32-C3-WROOM-02_V006
R0201_20210301.STEP^R0201_20210301.STEP_Submodel-R0201_part_DesignRootModel_PCB_ESP32-C3-WROOM-02_V1(2)_PCB_ESP32-C3-WROOM-02_V007
R0201_20210301.STEP^R0201_20210301.STEP_Submodel-R0201_part_DesignRootModel_PCB_ESP32-C3-WROOM-02_V1(2)_PCB_ESP32-C3-WROOM-02_V009
R0201_20210301.STEP^R0201_20210301.STEP_Submodel-R0201_part_DesignRootModel_PCB_ESP32-C3-WROOM-02_V1(2)_PCB_ESP32-C3-WROOM-02_V010
R0201_20210301.STEP^R0201_20210301.STEP_Submodel-R0201_part_DesignRootModel_PCB_ESP32-C3-WROOM-02_V1(2)_PCB_ESP32-C3-WROOM-02_V011
R0201_20210301.STEP^R0201_20210301.STEP_Submodel-R0201_part_DesignRootModel_PCB_ESP32-C3-WROOM-02_V1(2)_PCB_ESP32-C3-WROOM-02_V013
R0201_20210301.STEP^R0201_20210301.STEP_Submodel-R0201_part_DesignRootModel_PCB_ESP32-C3-WROOM-02_V1(2)_PCB_ESP32-C3-WROOM-02_V014
R0201_20210301.STEP^R0201_20210301.STEP_Submodel-R0201_part_DesignRootModel_PCB_ESP32-C3-WROOM-02_V1(2)_PCB_ESP32-C3-WROOM-02_V015
R0201_20210301.STEP^R0201_20210301.STEP_Submodel-R0201_part_DesignRootModel_PCB_ESP32-C3-WROOM-02_V1(2)_PCB_ESP32-C3-WROOM-02_V017
R0201_20210301.STEP^R0201_20210301.STEP_Submodel-R0201_part_DesignRootModel_PCB_ESP32-C3-WROOM-02_V1(2)_PCB_ESP32-C3-WROOM-02_V018
R0201_20210301.STEP^R0201_20210301.STEP_Submodel-R0201_part_DesignRootModel_PCB_ESP32-C3-WROOM-02_V1(2)_PCB_ESP32-C3-WROOM-02_V019
R0201_20210301.STEP^R0201_20210301.STEP_Submodel-R0201_part_DesignRootModel_PCB_ESP32-C3-WROOM-02_V1(2)_PCB_ESP32-C3-WROOM-02_V021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
