hutscape/capsicum/case/exports/top.stl

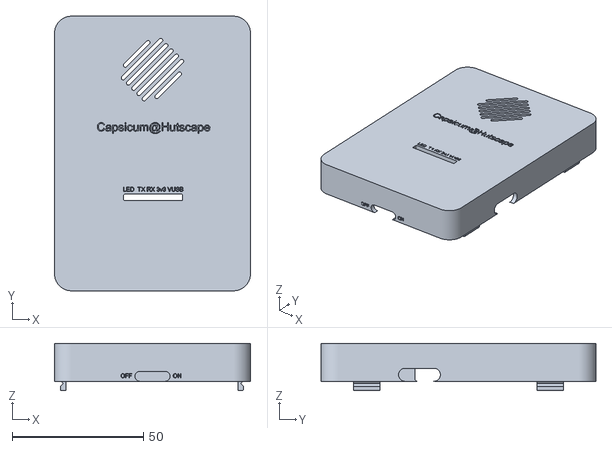
[picture p59: CAD file, 2024-02-16]
case/exports/top.stl
74.8 x 104.8 x 18.1
