hutscape/capsicum/case/exports/bottom.stl

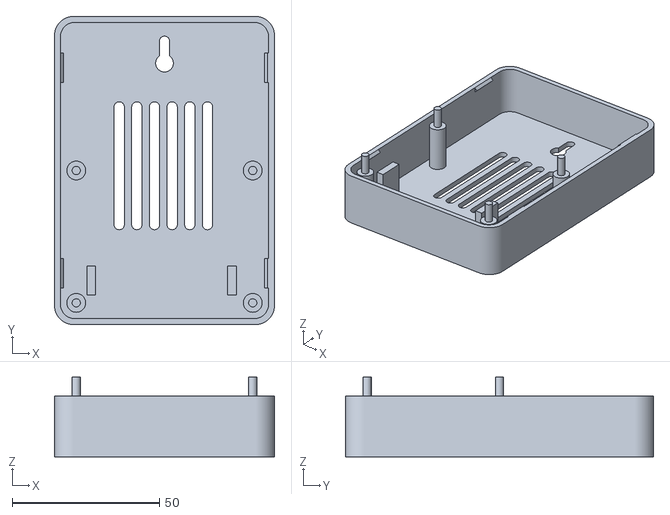
[picture p60: CAD file, 2024-02-16]
case/exports/bottom.stl
74.8 x 104.8 x 27.1
