hutscape/capsicum/(list of files, cad)

Other CAD files:
case/exports/case.stl
