hutscape/capsicum/start/step1.md

**Teardown**

Look into the internals of an existing [wired battery-powered doorbell from FUERS](https://s.click.aliexpress.com/e/_Dm6bTXf) bought on AliExpress, priced below USD $4.00.

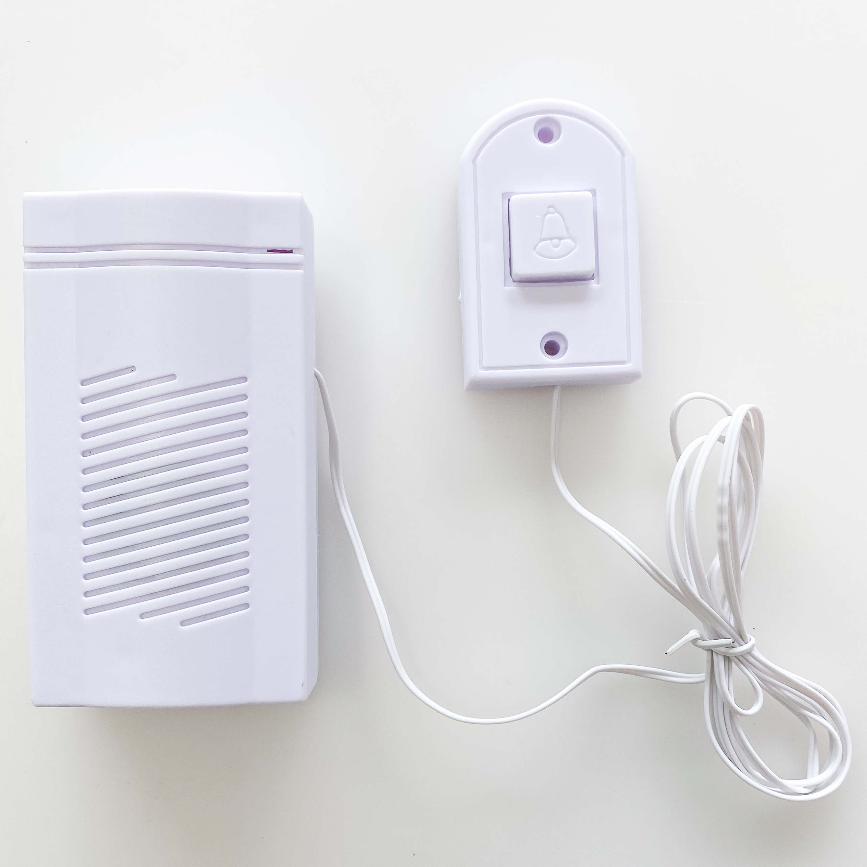
[picture p61: images/prototype/doorbell.jpg]
FUERS Wired Guest Welcome Doorbell High Quality Energy-saving Door bell Simple Generous Home Store Security Doorbell Button


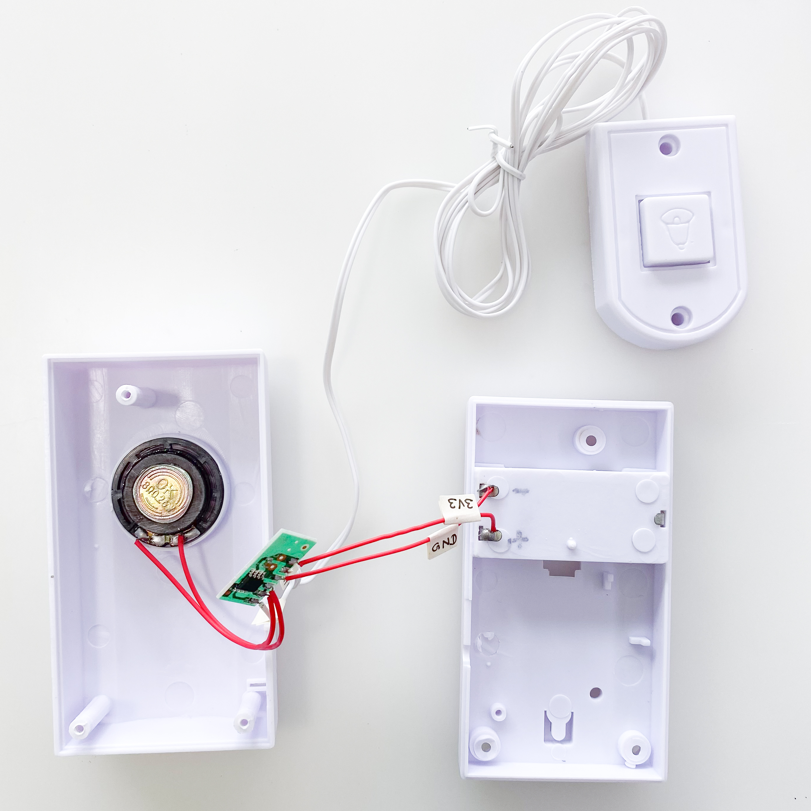
[picture p62: images/prototype/prototype-3.jpg]


**Battery**

It is powered by 2 AAA batteries (3V).

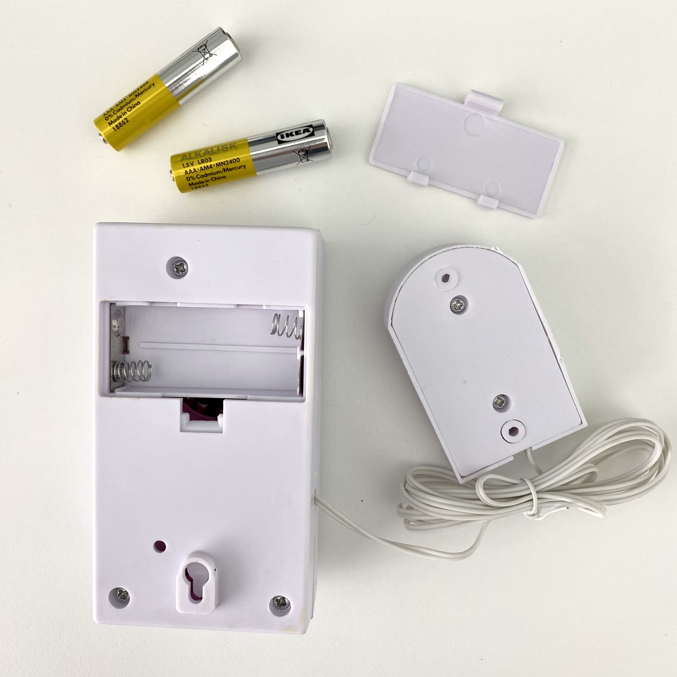
[picture p63: images/prototype/initial-doorbell-power.jpg]
Power by 2 AAA batteries
