hutscape/capsicum/start/step2.md

**Chip**

Chip TLX210924 is similar to [TQ33E-11](https://www.yoycart.com/Product/550682313846/). It rings "Ding Dong" 2 times. It is a Music chip with a built-in transistor positive trigger and has 6 pinouts from the PCB.

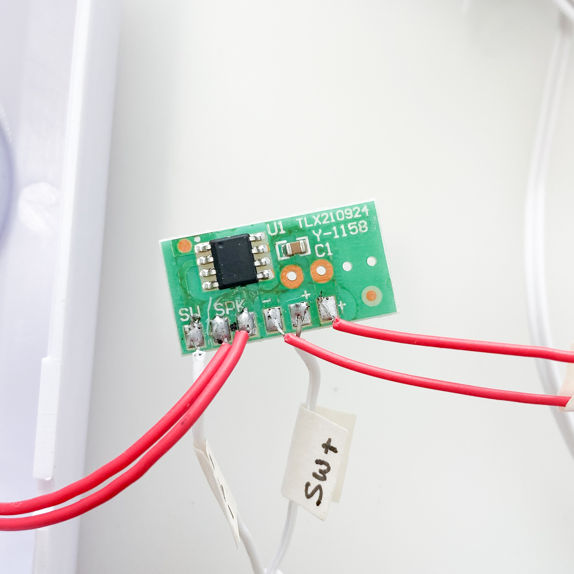
[picture p64: images/prototype/prototype-5.jpg]
Chip of the original doorbell


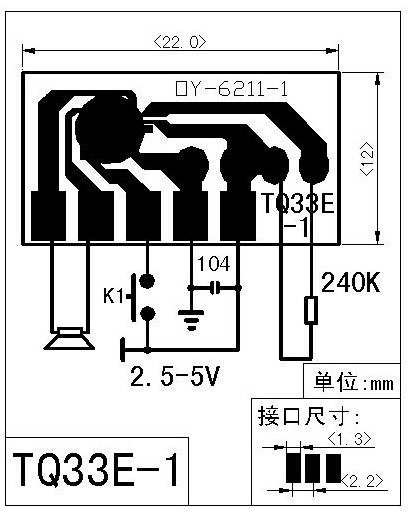
[picture p65: images/prototype/initial-doorbell-circuit.jpeg]
Chip circuit


**Speaker**

A speaker of `8ohms`, `0.25W` is used.

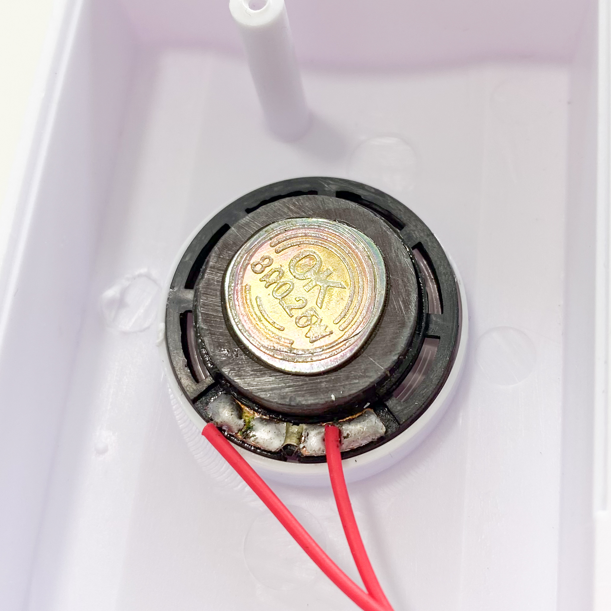
[picture p66: images/prototype/prototype-4.jpg]
Back of the Chip of the original doorbell
