hutscape/capsicum/start/step3.md

**Prototype**

Wire up the TQ33E-11 chip with breadboard.

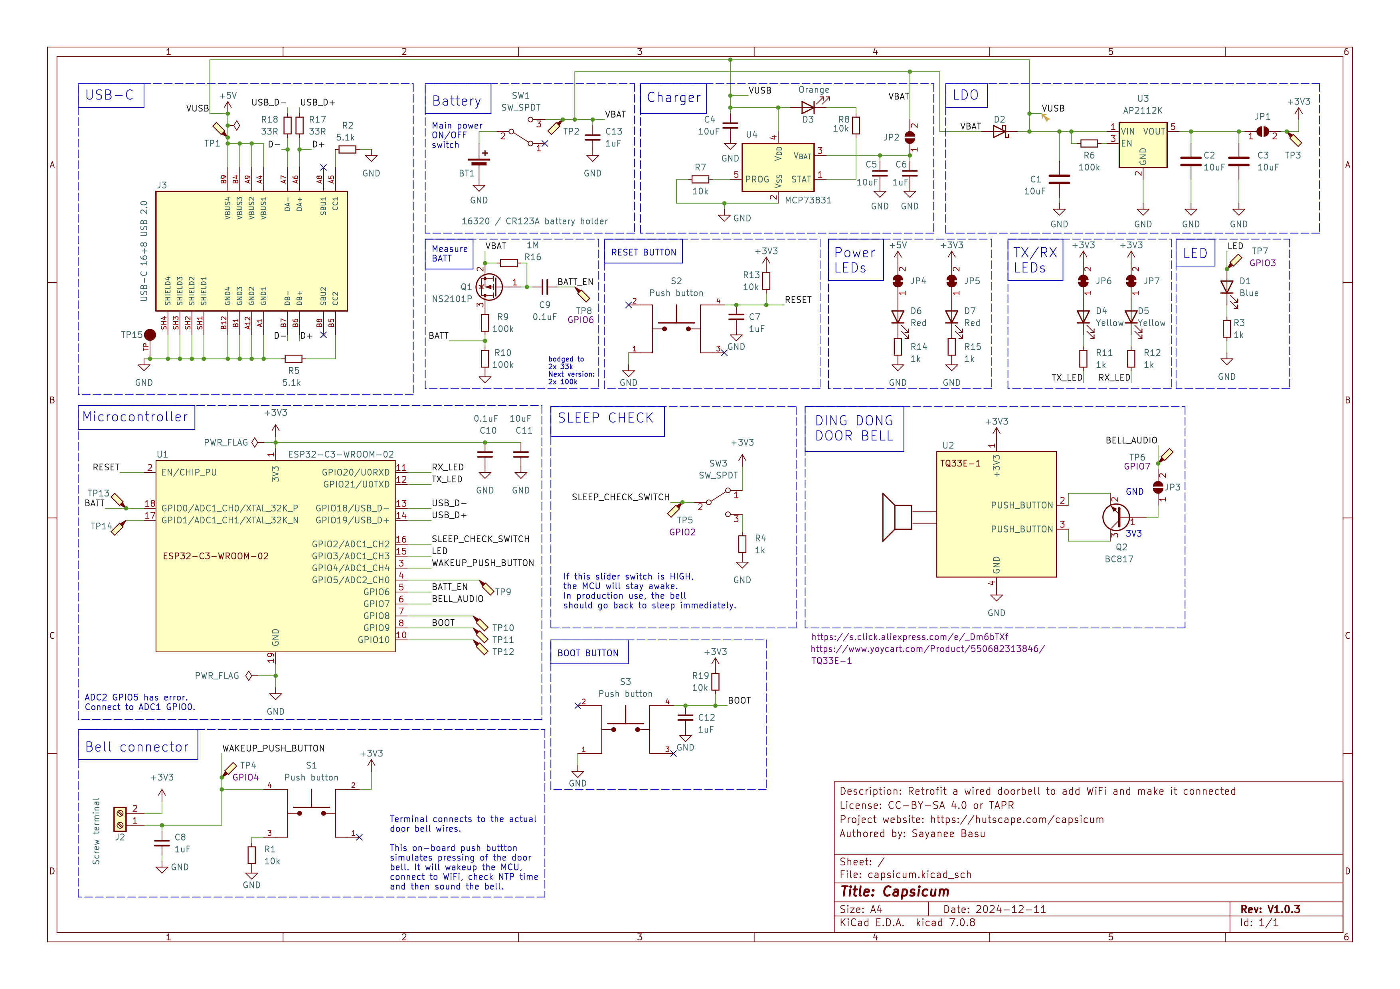
[picture p67: images/pcb/schematic.png]
Schematic of the breadboard


Prototype

Upload the [firmware](/code/demo#code) and view the serial monitor.

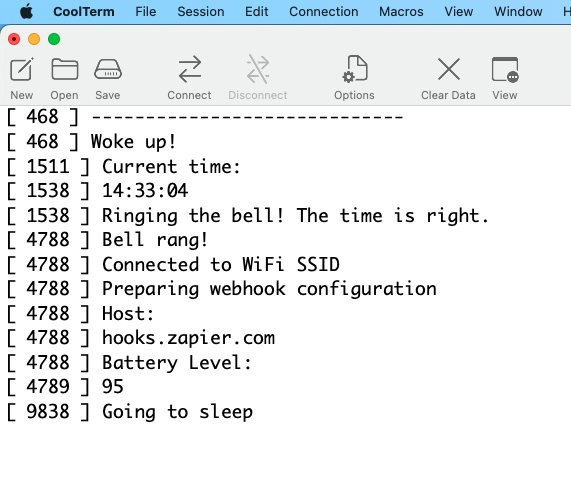
[picture p68: images/code/demo-console.png]
Serial monitor
