hutscape/capsicum/images/case/case_manufacturing_params.png

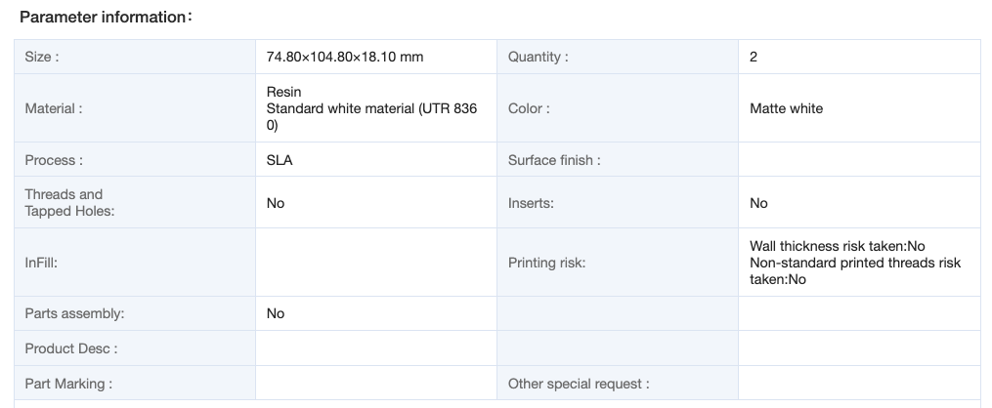
images/case/case_manufacturing_params.png
