hutscape/capsicum/images/code/measure-battery-level-prototype.jpg

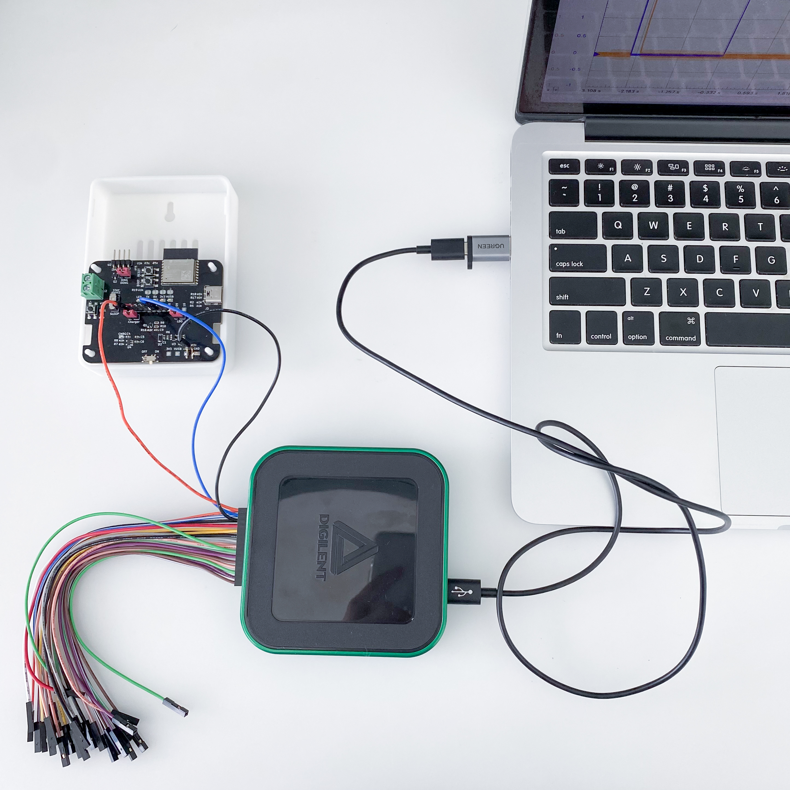
images/code/measure-battery-level-prototype.jpg
