hutscape/capsicum/images/code/measure-battery-level-schematic.png

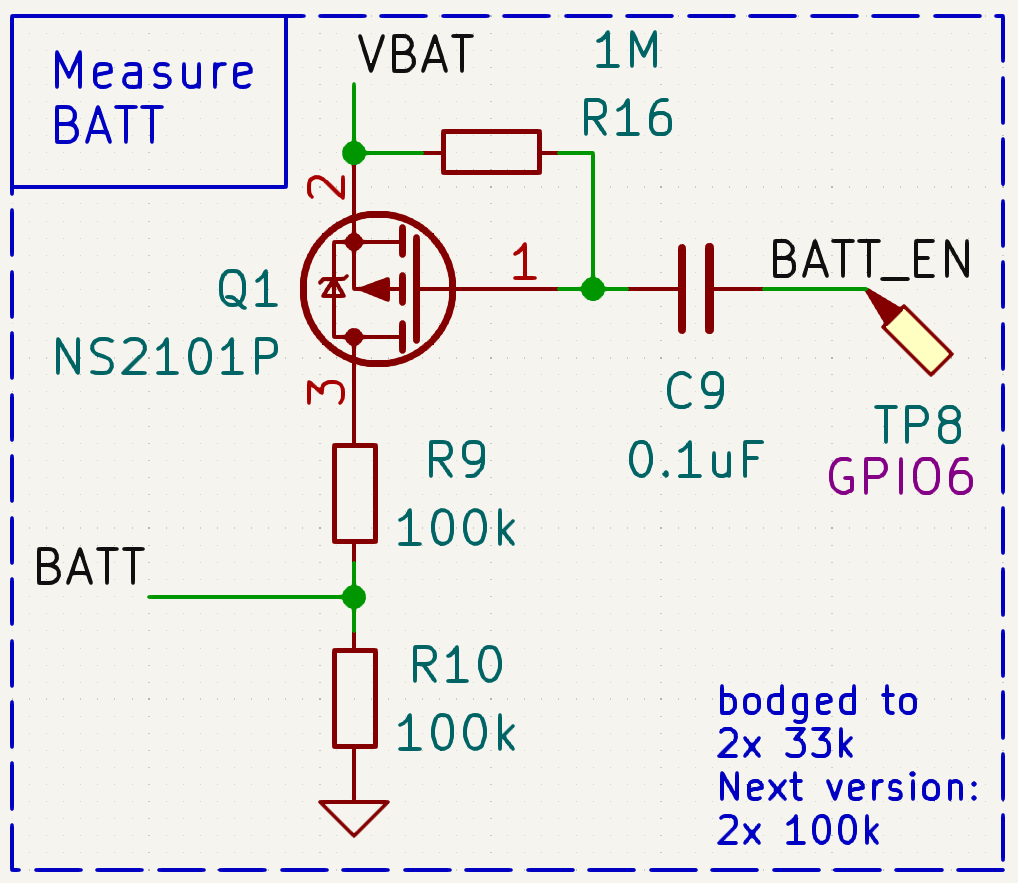
images/code/measure-battery-level-schematic.png
