hutscape/capsicum/(threads)

Thread 3 (2021-05-26):

ESP32 Resources

sayanee, 2021-05-26:
- [m5Stack docs for Arduino development](https://docs.m5stack.com/en/arduino/arduino_development)
- [M5Stack Core datasheets + Schematic](https://github.com/m5stack/M5-Schematic/tree/master/Core)
- [ESP32 Boards Comparison List](https://docs.google.com/spreadsheets/d/1Mu-bNwpnkiNUiM7f2dx8-gPnIAFMibsC2hMlWhIHbPQ/edit#gid=0) from [Andreas Spiess](https://www.youtube.com/watch?v=mnoZYlyebBc)

## Board

[LILYGO® TTGO T8 ESP32-S2 V1.1](http://www.lilygo.cn/prod_view.aspx?TypeId=50033&Id=1300&FId=t3:50033:3)

## Arduino firmware

[ESP32 S2 Support](https://github.com/espressif/arduino-esp32/tree/master#esp32-s2-and-esp32-c3-support)

Closed 2024-01-04.

Thread 4 (2024-02-29):

Minimum wall thickness requirement for 3D printing in ABS

sayanee, 2024-02-29:
Manufacturing params:

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

Annotations:

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

Review check failed reason:

> Wall thickness in the design has not reached at least 1mm, please modify the file. Suggest increasing the width of letters to 0.8mm or more.

Thread 5 (2024-04-11):

BATT voltage measurement pin on ESP32-C3 pin 5 has error

sayanee, 2024-04-11:
## Description

`Pin 5` on ESP32-C3 is ADC2. And when using it to measure analog voltage, it gives the following error:

```
E (14210) ADC: ADC2 is no longer supported, please use ADC1. Search for errata on espressif website for more details. You can enable ADC_ONESHOT_FORCE_USE_ADC2_ON_C3 to force use ADC2
E (14215) ADC: adc2_get_raw(750): adc unit not supported
```

## Steps to Reproduce

Measure analog value from the pin

```
#define BATTERY_MEASURE_PIN 5
...
int rawValue = analogRead(BATTERY_MEASURE_PIN);
```

## Expected Behavior

There shouldn't be any error.

## Actual Behavior

That line of code gives an error:

```
E (14210) ADC: ADC2 is no longer supported, please use ADC1. Search for errata on espressif website for more details. You can enable ADC_ONESHOT_FORCE_USE_ADC2_ON_C3 to force use ADC2
E (14215) ADC: adc2_get_raw(750): adc unit not supported
```

## Environment

- Arduino firmware
- [Espressif errata](https://www.espressif.com/sites/default/files/documentation/esp32-c3_errata_en.pdf)

## Screenshot

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

sayanee, 2024-04-11:
## Fix schematic

Change `BATT` from `GPIO5` (ADC2) to `GPIO0` (ADC1).

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

## Fix layout

- Cut trace from `R9` to test point `GPIO05`
- Add new bodge wire from `R9` to test point `GPIO0`

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

sayanee, 2024-07-09:
`R9` connected to `GPIO0`

### Schematic

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

### Layout

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

sayanee, 2024-07-09:
Closed with 61efc72173ea0ea0a2b0cf0940e66e0a65f15c36

Closed 2024-07-09.

Thread 6 (2024-04-16):

Battery measurement circuit does not work

sayanee, 2024-04-16:
**Describe the bug**
`GPIO6`, the `BATT_EN` is always `0V` and the MOSFET `Q1` is never turned ON.

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

**To Reproduce**
Steps to reproduce the behavior:
1. Ensure the bodge is applied #5
2. Upload the `measure-battery-level.ino` [firmware](https://github.com/hutscape/capsicum/blob/main/_code/measure-battery-level/measure-battery-level.ino) to the board
3. Measure `GPIO6` voltage with multimeter
4. See that the voltage at that pin does not change

**Expected behavior**
The voltage measured at `GPIO6` should change every 2 seconds to turn on and off the MOSFET so that `GPIO0` can measure the analog level.

**Actual behavior**
The voltage measured at `GPIO6` is always at `0V`.

**Versions (please complete the following information):**
 - OS: macOS

**Additional context**

The [Falstad simulation](https://www.falstad.com/circuit/circuitjs.html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) works!

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

**TODO**

Bodge this issue and #5 to release new Gerbers and version.

sayanee, 2024-07-09:
ADC 4095 is at 2.8V (not 3.3V) [[Reference](https://forum.arduino.cc/t/esp32-c3-adc-issue-reading-4095-at-2-8v/1127687)]

sayanee, 2024-07-09:
Closed with 61efc72173ea0ea0a2b0cf0940e66e0a65f15c36

Closed 2024-07-09.

Thread 7 (2024-12-13):

Improvements for the next major version 2.0

sayanee, 2024-12-13:
## Enhancements for Version 2.0

### Schematic

- [ ] Use a <a href="https://github.com/makermoekoe/Picoclick-C3/blob/main/pcb/Picoclick_C3T/picoclick_c3t_v1_bom.csv#L18">single RGB LED</a> for status indication
- [ ] Add <a href="https://forum.kicad.info/t/understanding-multi-sheet-schematics/42922/2">multi sheet schematics</a> for better readability
- [ ] Add component images and parameter graphs <a href="https://github.com/EPFLXplore/XRE_LeggedRobot_HW/blob/master/amulet_controller/Schematic/amulet_controller.pdf">for better understanding</a>
- [ ] Add a switch to turn on and off wireless communication to fallback to legacy functionality

### Layout

- [ ] Use <a href="https://docs.kicad.org/8.0/en/pcbnew/pcbnew.html">teardrops</a> in KiCAD 8.0
- [ ] Add <a href="https://youtu.be/g4m91gv-4oQ?t=1088">fudicial markers</a> for pick and place
- [ ] Add silkscreen pin labels for all connectors that extend outside the PCB E.g. pin headers or USB-C
- [ ] <a href="https://www.fiveflute.com/guide/design-for-assembly-dfa-best-practices/"> Mistake-proof assembly</a> by designing the case and PCB to fit only one way, E.g.asymmetric screw holes, PCB shape and screw lugs
- [ ] Add a header male pin (GND and VUSB/VBAT) to use with the nRF profiler for power consumption measurements

### BOM

- [ ] Use a better quality <a href="https://www.digikey.com/en/products/detail/nidec-components-corporation/CL-SB-22A-11T/3507836">slide switch DPDT</a> for <a href="https://www.nordicsemi.com/Products/Development-hardware/Power-Profiler-Kit-2/Download#infotabs">better tactile feedback</a>

### Case

- [ ] Make the text height bigger for LEDs and ON/OFF power switch
- [ ] Add more chamfers and rounded corners for a better aesthetic
- [ ] **Teeth and groves** - Make the teeth thicker for better strength
- [ ] **Teeth and groves** - Add a holder in the teeth so that the top and bottom cases do not slide
- [ ] **Teeth and grooves** - Include visual cues on the exterior for finger placement
- [ ] PCB holder screw lug can be shorter
- [ ] Add an LED slot to view the charge LED from the outside without opening the case
- [ ] Add <a href="https://www.pollen.am/design_for_3d_printing_edges_fillets_ribs/">filletted poles</a> for screw lugs and holders on the case base
- [ ] Ensure the charging LED is visible from the outside through a slot or a transparent window
- [ ] Ensure the charging cable position on the case is accessible to the power socket on-site for charging
- [ ] Add more rounded corners and chamfers for <a href="https://www.pinterest.com/sayanee/product-design/">timeless product design</a> enclosures
- [ ] Following DFA (Design for Assembly), make the case easier to assemble by creating asymmetric screw hole positions on the PCB and case

### Firmware

- [ ] (Firmware) Use <a href="https://github.com/arduino-libraries/Arduino_ESP32_OTA">OTA updates</a> for firmware

### Power

- [ ] **Battery** - Use a flat LiPo battery for a compact case design

### Chore

- [ ] Use Conventional Commit Messages for <a href="https://www.conventionalcommits.org/en/v1.0.0/">better git history</a> with scopes such as firmware, case, schematic, layout, docs, BOM, power, design, website, chore (CI/CD/updates).
