hutscape/capsicum/pcb/docs/schematic.pdf

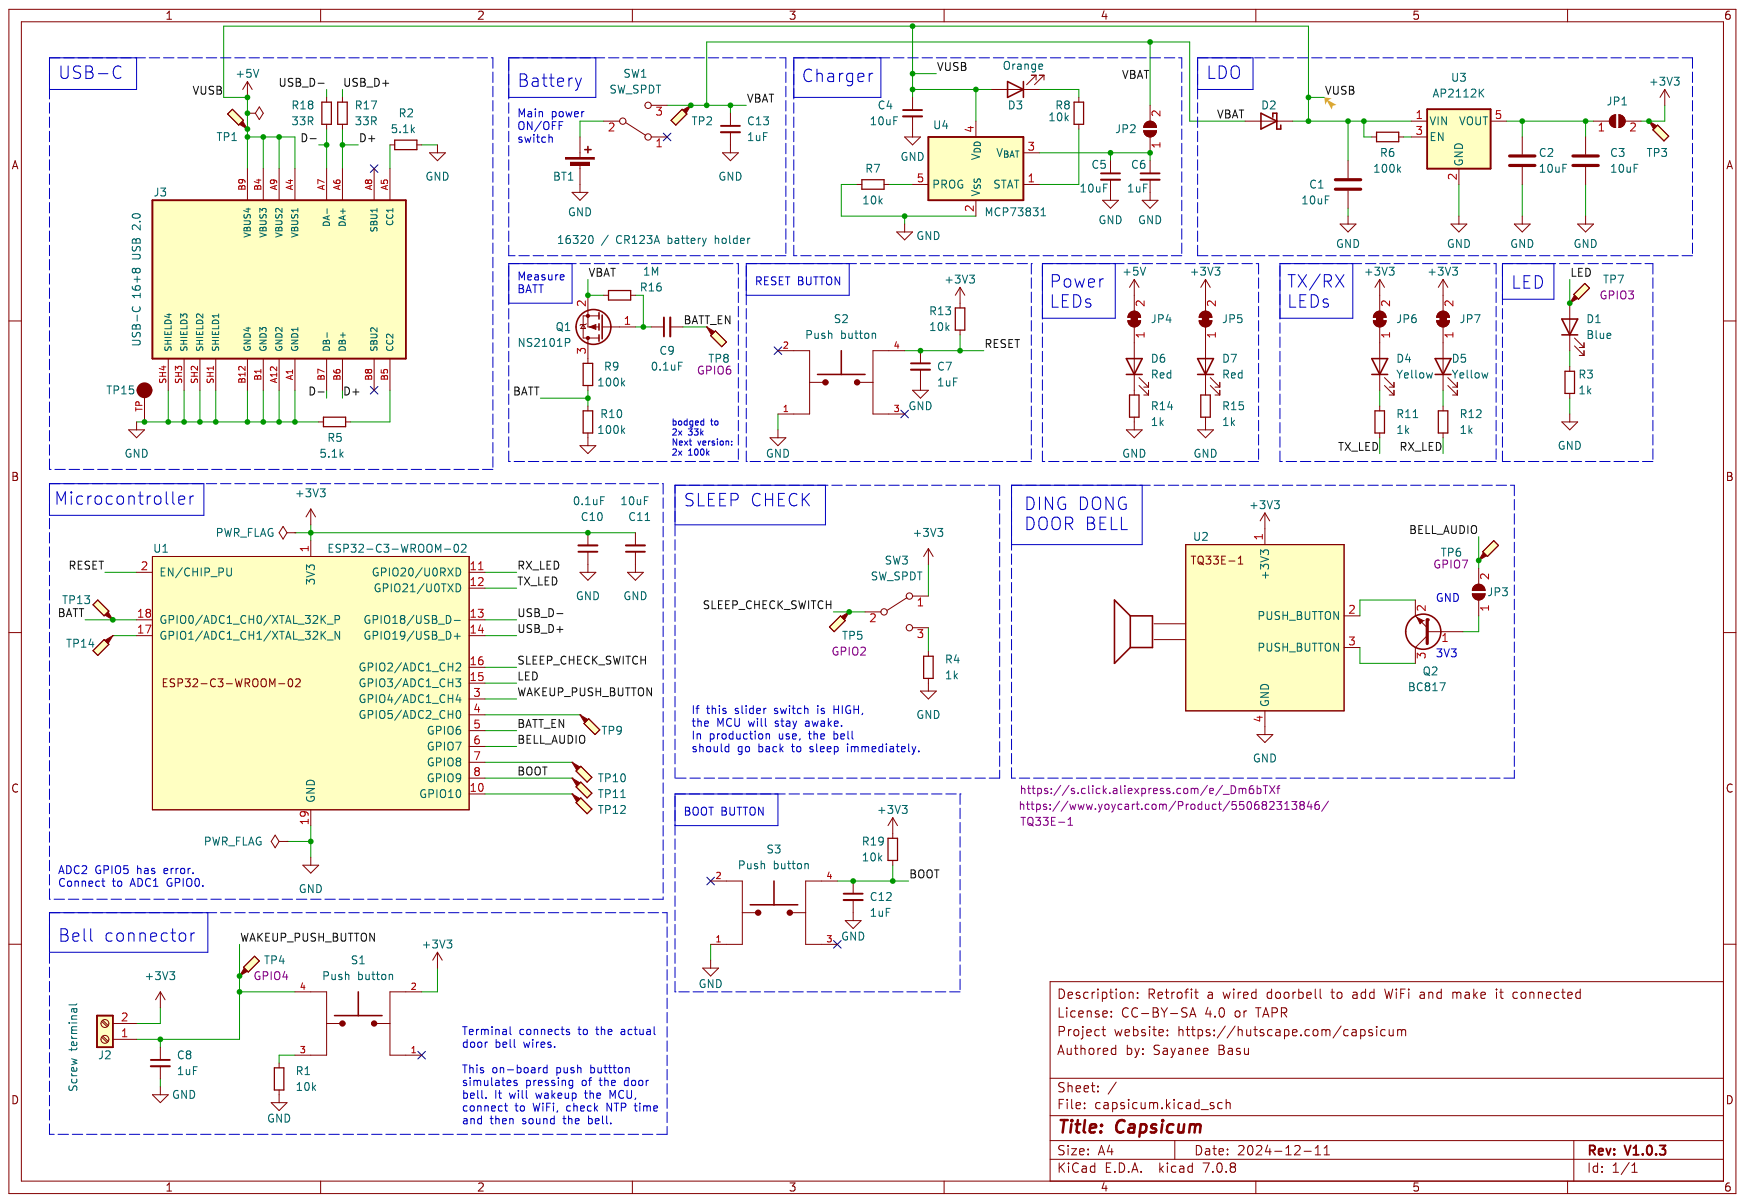
[picture p76: page 1]
