hutscape/capsicum/pcb/capsicum.kicad_pcb

## KiCad design pcb/capsicum.kicad_pcb (2024-12-11)

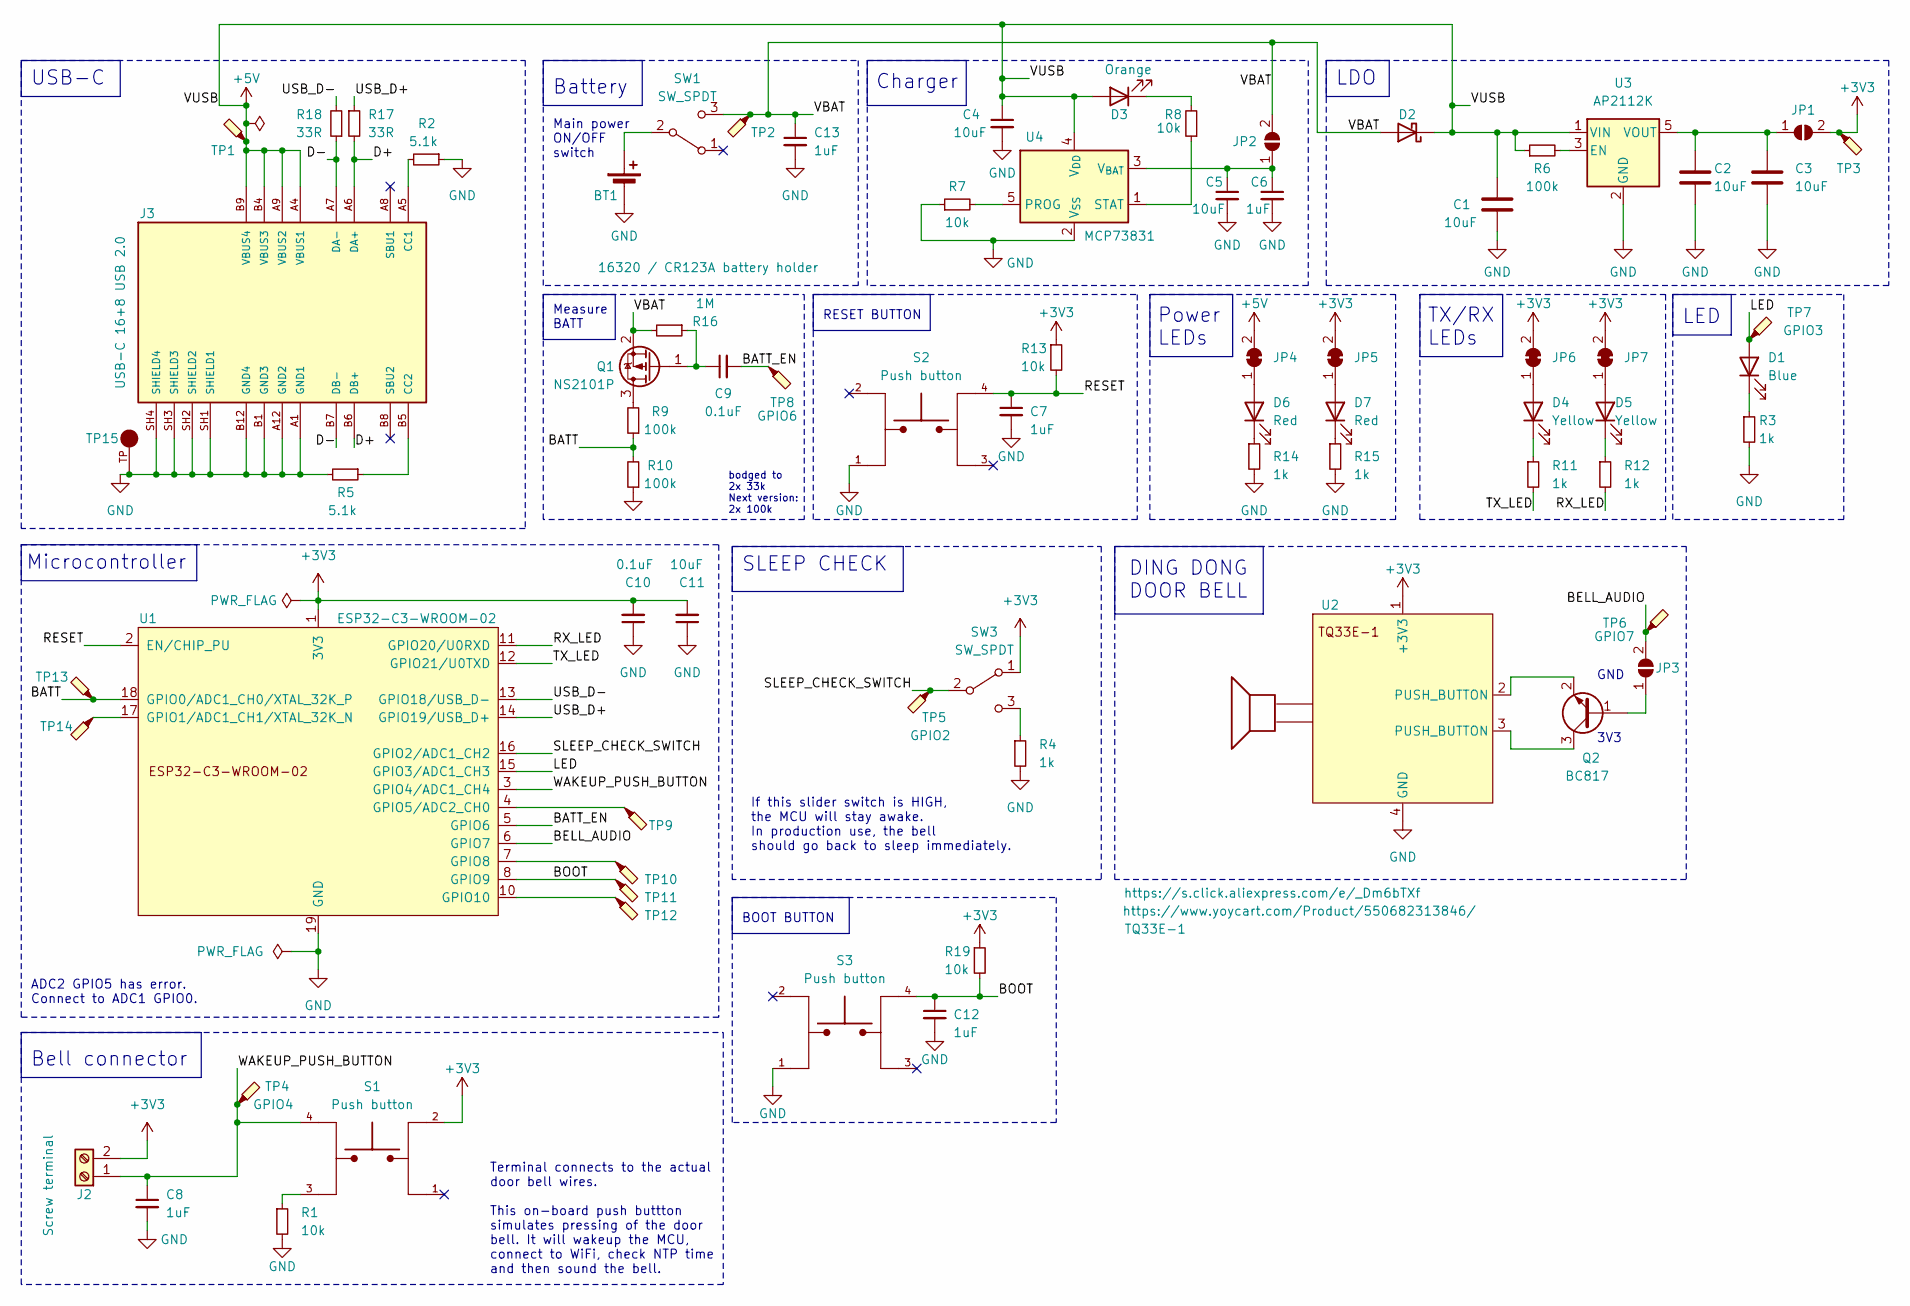
[picture p91: schematic capsicum.kicad_sch]

Parts:
BT1: 16320 / CR123A battery holder; CR123_holder
C1, C2, C3, C4, C5, C11: 10uF; C_0603_1608Metric; MPN CC0603KRX5R6BB106
C6, C7, C8, C12, C13: 1uF; C_0603_1608Metric; MPN 06033D105MAT2A
C9, C10: 0.1uF; C_0603_1608Metric; MPN 06033C104KAT4A
D1: Blue; D_0603_1608Metric; MPN 150060BS75000
D2: D_Schottky; D_SOD-123F; MPN PMEG3020EH,115
D3: Orange; D_0603_1608Metric; MPN B1911UD--20D001014U1930
D4, D5: Yellow; D_0603_1608Metric; MPN 150060YS75000
D6, D7: Red; D_0603_1608Metric; MPN 150060RS75000
J2: Screw terminal; phoenix_screw_terminal_th_1935161; MPN 1935161
J3: USB-C 16+8 USB 2.0; Molex_USB_C_2137160001; PARTREV B
JP1, JP2, JP3: SolderJumper_2_Open; PinHeader_1x02_P2.54mm_Vertical; MPN 61300211121
JP4, JP5, JP6, JP7: SolderJumper_2_Bridged; SolderJumper-2_P1.3mm_Bridged_RoundedPad1.0x1.5mm
Q1: NS2101P; SOT-323_SC-70; MPN NTS2101PT1G
Q2: BC817; SOT-23-3; MPN BC817-16LT3G
R1, R7, R8, R13, R19: 10k; R_0603_1608Metric; MPN RC0603FR-0710KL
R2, R5: 5.1k; R_0603_1608Metric; MPN ERJ-3GEYJ512V
R3, R4, R11, R12, R14, R15: 1k; R_0603_1608Metric; MPN RC0603FR-071KL
R6, R9, R10: 100k; R_0603_1608Metric; MPN RMCF0603FT100K
R16: 1M; R_0603_1608Metric; MPN RC0603FR-071ML
R17, R18: 33R; R_0603_1608Metric; MPN RC0603JR-0733RL
S1, S2, S3: Push button; SW_TL3305AF160QG; PARTREV C
SW1: SW_SPDT; SW_SPDT_PCM12; MPN CUS-12TB
SW3: SW_SPDT; SW_JS102011JCQN; MPN JS102011JCQN
TP1, TP2, TP3, TP4, TP5, TP6, TP7, TP8, TP9, TP10, TP11, TP12, TP13, TP14: TestPoint_Probe; TestPoint_Pad_1.5x1.5mm
TP15: 5015; Keystone_test_point_5015; MPN 5015
U1: ESP32-C3-WROOM-02; MPN ESP32-C3-WROOM-02-N4
U2: R/A 4x1 2.54mm pin header; PinHeader_1x04_P2.54mm_Horizontal; MPN PH1RB-04-UA
U3: AP2112K; SOT-23-5; MPN AP2112K-3.3TRG1
U4: MCP73831; SOT-23-5; MPN MCP73831T-2ACI/OT

Connections:
+3V3: C10.2, C11.2, J2.2, JP1.2 (B), JP5.2 (B), JP6.2 (B), JP7.2 (B), R13.1, R19.1, S1.2, SW3.1 (A), TP3.1, U1.1 (3V3), U2.1 (+3V3)
+5V: C1.1, C4.1, D2.1 (K), D3.2 (A), J3.A4 (VBUS1), J3.A9 (VBUS2), J3.B4 (VBUS3), J3.B9 (VBUS4), JP4.2 (B), R6.1, TP1.1, U3.1 (VIN), U4.4 (V_{DD})
/BATT: R9.1, R10.2, TP13.1, U1.18 (GPIO0/ADC1_CH0/XTAL_32K_P)
/BATT_EN: C9.2, TP8.1, U1.5 (GPIO6)
/BELL_AUDIO: JP3.2 (B), TP6.1, U1.6 (GPIO7)
/BOOT: C12.1, R19.2, S3.4, TP11.1, U1.8 (GPIO9)
/D+: J3.A6 (DA+), J3.B6 (DB+), R17.2
/D-: J3.A7 (DA-), J3.B7 (DB-), R18.1
/LED: D1.2 (A), TP7.1, U1.15 (GPIO3/ADC1_CH3)
/RESET: C7.1, R13.2, S2.4, U1.2 (EN/CHIP_PU)
/RX_LED: R12.2, U1.11 (GPIO20/U0RXD)
/SLEEP_CHECK_SWITCH: SW3.2 (B), TP5.1, U1.16 (GPIO2/ADC1_CH2)
/TX_LED: R11.2, U1.12 (GPIO21/U0TXD)
/USB_D+: R17.1, U1.14 (GPIO19/USB_D+)
/USB_D-: R18.2, U1.13 (GPIO18/USB_D-)
/VBAT: C13.1, D2.2 (A), JP2.2 (B), Q1.2 (S), R16.2, SW1.3 (C), TP2.1
/WAKEUP_PUSH_BUTTON: C8.1, J2.1, S1.4, TP4.1, U1.3 (GPIO4/ADC1_CH4)
GND: BT1.2 (-), C1.2, C2.2, C3.2, C4.2, C5.2, C6.2, C7.2, C8.2, C10.1, C11.1, C12.2, C13.2, J3.A1 (GND1), J3.A12 (GND2), J3.B1 (GND3), J3.B12 (GND4), J3.SH1 (SHIELD1), J3.SH2 (SHIELD2), J3.SH3 (SHIELD3), J3.SH4 (SHIELD4), R1.2, R2.1, R3.2, R4.2, R5.2, R7.1, R10.1, R14.2, R15.2, S2.1, S3.1, TP15.TP, U1.9 (GND), U1.19 (GND), U2.4 (GND), U3.2 (GND), U4.2 (V_{SS})
unnamed: BT1.1 (+), SW1.2 (B)
unnamed: D1.1 (K), R3.1
unnamed: D3.1 (K), R8.2
unnamed: D4.2 (A), JP6.1 (A)
unnamed: D4.1 (K), R11.1
unnamed: D5.2 (A), JP7.1 (A)
unnamed: D5.1 (K), R12.1
unnamed: D6.2 (A), JP4.1 (A)
unnamed: D6.1 (K), R14.1
unnamed: D7.2 (A), JP5.1 (A)
unnamed: D7.1 (K), R15.1
unnamed: J3.A5 (CC1), R2.2
unnamed: J3.B5 (CC2), R5.1
unnamed: C2.1, C3.1, JP1.1 (A), U3.5 (VOUT)
unnamed: C5.1, C6.1, JP2.1 (A), U4.3 (V_{BAT})
unnamed: JP3.1 (A), Q2.1 (B)
unnamed: Q1.3 (D), R9.2
unnamed: C9.1, Q1.1 (G), R16.1
unnamed: Q2.3 (C), U2.3 (PUSH_BUTTON)
unnamed: Q2.2 (E), U2.2 (PUSH_BUTTON)
unnamed: R1.1, S1.3
unnamed: R4.1, SW3.3 (C)
unnamed: TP14.1, U1.17 (GPIO1/ADC1_CH1/XTAL_32K_N)
unnamed: TP9.1, U1.4 (GPIO5/ADC2_CH0)
unnamed: TP10.1, U1.7 (GPIO8)
unnamed: TP12.1, U1.10 (GPIO10)
unnamed: R6.2, U3.3 (EN)
unnamed: R7.2, U4.5 (PROG)
unnamed: R8.1, U4.1 (STAT)

Notes on the sheet:
LED
Terminal connects to the actual door bell wires. This on-board push buttton simulates pressing of the door bell. It will wakeup the MCU, connect to WiFi, check NTP time and then sound the bell.
TX/RX LEDs
bodged to 2x 33k Next version: 2x 100k
Main power ON/OFF switch
If this slider switch is HIGH, the MCU will stay awake. In production use, the bell should go back to sleep immediately.
3V3
Measure BATT
SLEEP CHECK
ADC2 GPIO5 has error. Connect to ADC1 GPIO0.
RESET BUTTON
Charger
BOOT BUTTON
USB-C
Bell connector
DING DONG DOOR BELL
Microcontroller
GND
Power LEDs
Battery
LDO

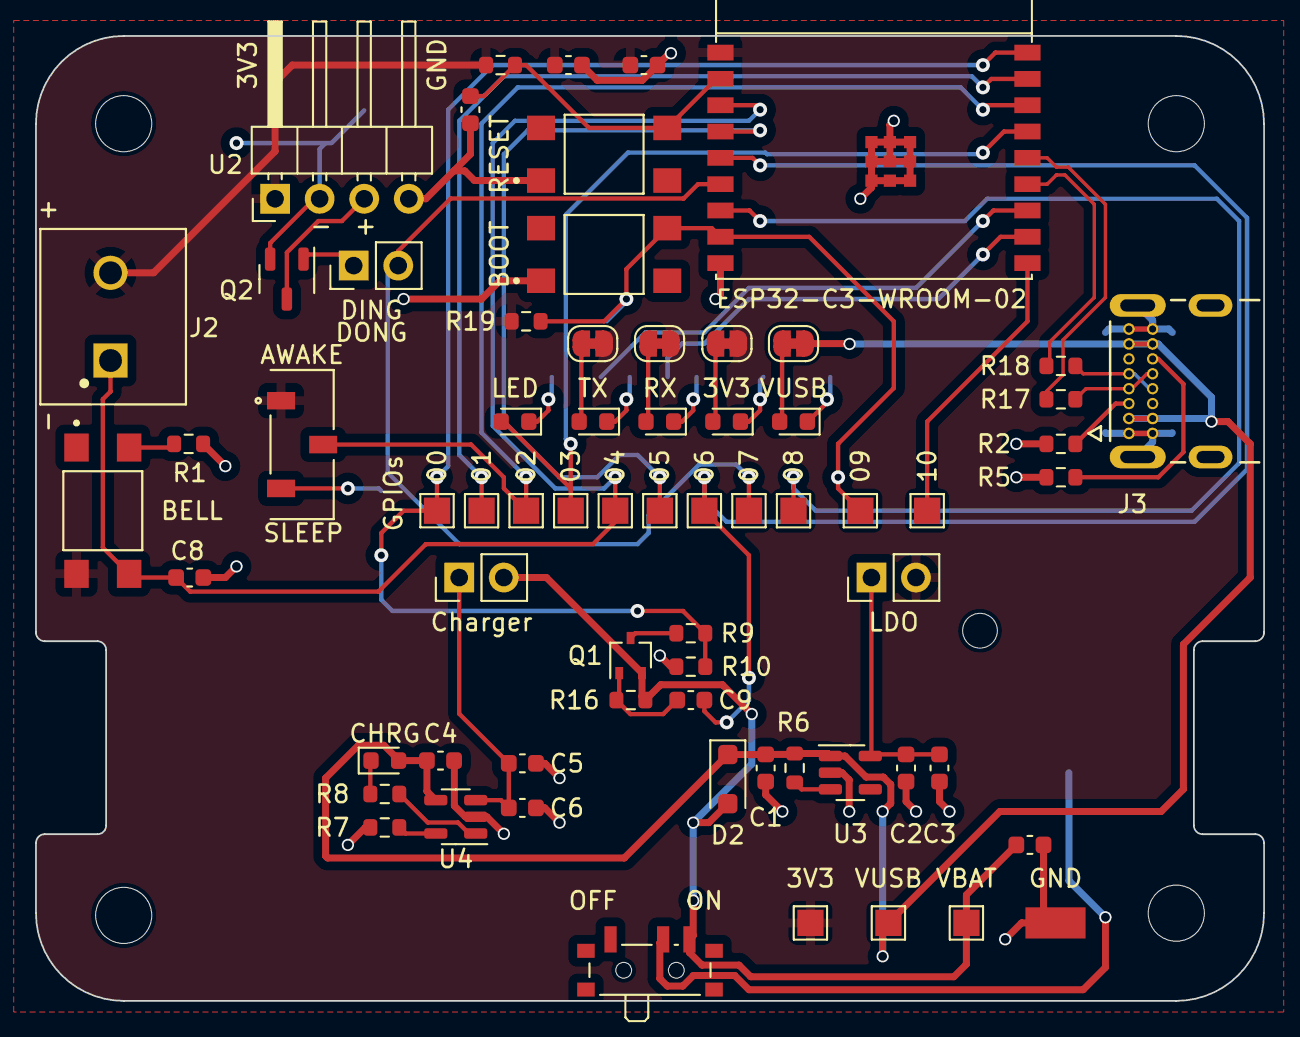
[picture p92: board capsicum.kicad_pcb from above]

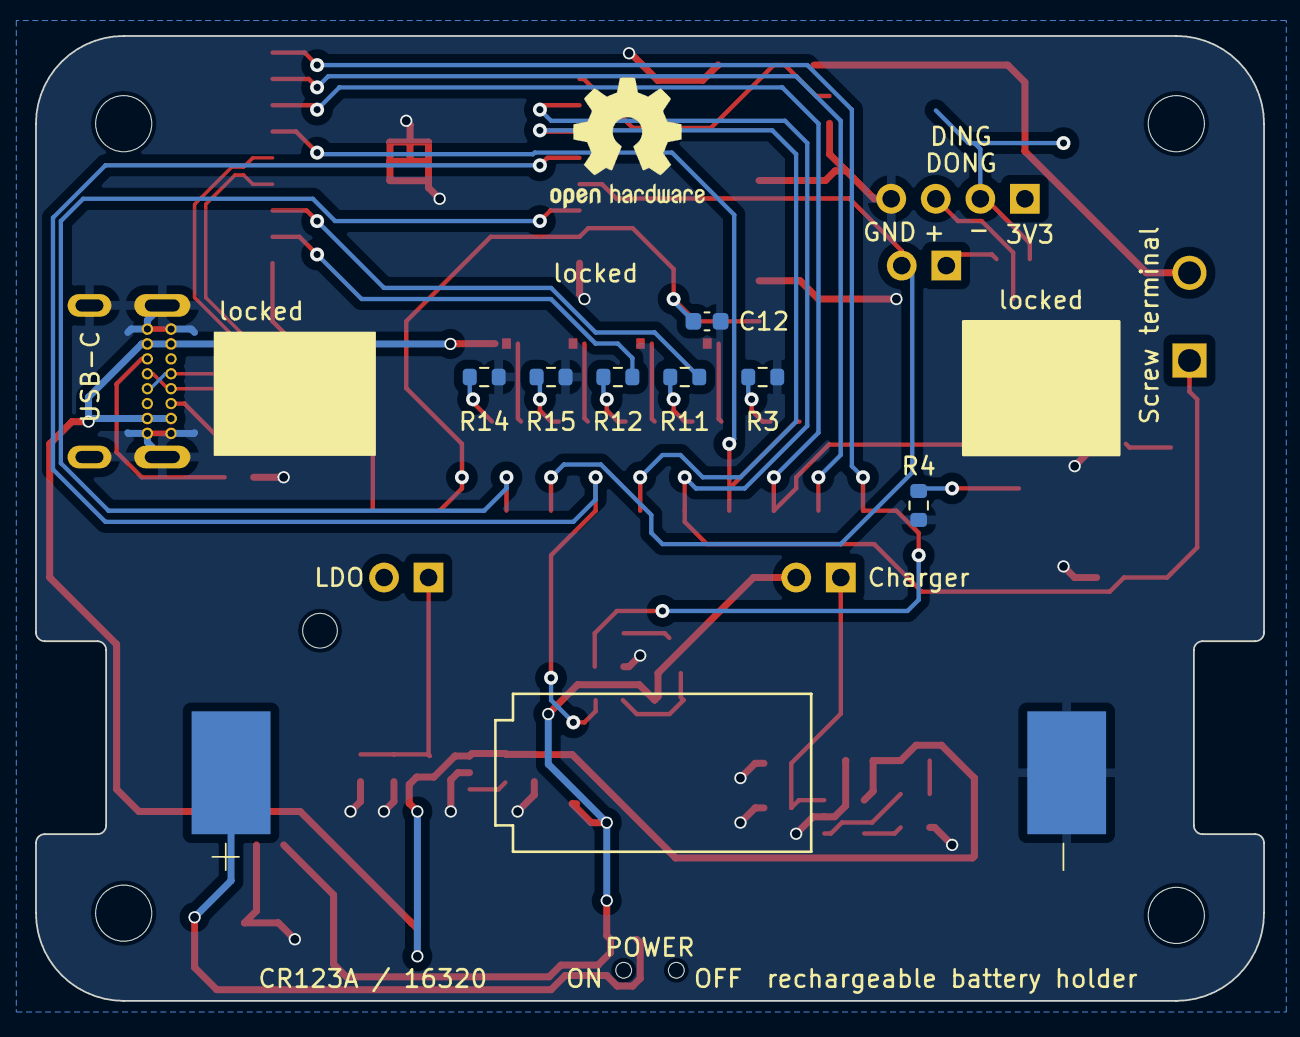
[picture p93: board capsicum.kicad_pcb from below]

Board: 2 copper layers, 70.0 x 55.0 mm, 75 parts (8 on the bottom side), 47 nets.
