hutscape/capsicum/_code/minimum-breadboard/minimum-breadboard.ino

// #define LED 3  // for the PCB
#define LED LED_BUILTIN  // for the breadboard with PCB

#define BELL_PIN 7
#define WAKEUP_INTERRUPT_PIN 4
RTC_DATA_ATTR int bootCount = 0;

void setup() {
  ++bootCount;
  Serial.begin(115200);

  Serial.println("Boot number: " + String(bootCount));

  // ring the bell
  Serial.println("Ringing the bell");
  pinMode(BELL_PIN, OUTPUT);
  digitalWrite(BELL_PIN, HIGH);
  delay(1000);
  digitalWrite(BELL_PIN, LOW);

  // blink the LED 10 times to indicate that the device is awake
  pinMode(LED, OUTPUT);
  for (int i = 0; i < 10; ++i) {
    digitalWrite(LED, HIGH);
    delay(1000);
    digitalWrite(LED, LOW);
    delay(1000);
  }

  // go to deep sleep
  Serial.println("Going to deep sleep now");

  esp_deep_sleep_enable_gpio_wakeup(1 << WAKEUP_INTERRUPT_PIN,
    ESP_GPIO_WAKEUP_GPIO_HIGH);
  esp_deep_sleep_start();
}

void loop() { }
