hutscape/capsicum/(commit log)

2022-04-20 refactor: make a parent data node for download buttons and add demo code link
2022-04-21 "refactor: seperate BOM page into more partials"
2022-05-19 "feat: add /case layout for projects with enclosure designs"
2022-07-22 chore: move images from hardware to pcb directory
2022-07-25 feat: add 3d printed case photos
2023-11-10 feat: add demo code to sound the buzzer when the push button is pressed
    [demo.ino]
2023-11-11 feat: add led controller
2023-11-11 feat: remain awake if the sleep check gpio pin is HIGH
2023-11-14 feat: add debug print statemetns
2023-11-14 feat: add debug print to ntp time manager
2023-11-14 feat: add debug print to sleep manager
2023-11-14 refactor: add debug prints
2023-11-15 docs: add updated image of the demo code schematic
2023-11-15 feat: add kicad schematic and files
    [esp32-c3.kicad_pcb, esp32-c3.kicad_sch]
2023-11-18 fix: fix currentHour check with NTP Time to ring the bell
    [demo.ino, timeManager.cpp, timeManager.h]
2023-11-20 fix: change extract hour from 12 hour to 24 hour
    [timeManager.cpp]
2023-11-23 feat: new demo code with KiCad schematic with TQE33-1 bell audio chip
    [capsicum.kicad_pcb, capsicum.kicad_sch, esp32-c3.kicad_sch]
2023-11-28 feat: add components in the schematic
    [capsicum.kicad_sch]
2023-11-28 feat: add reset button in the schematic
    [capsicum.kicad_sch]
2023-11-29 feat: add bell connector to the schematic
    [capsicum.kicad_sch]
2023-11-29 feat: associate 0603 capcitors and resistors footprints
    [capsicum.kicad_sch]
2023-12-03 refactor: add power LEDs, combine wakeup button schematic and simplify comment
    [capsicum.kicad_sch]
2023-12-04 refactor: add battery measurement circuit that saves power draw
    [capsicum.kicad_sch]
2023-12-05 feat: associate package to LDO and charger
    [capsicum.kicad_sch]
2023-12-06 feat: associate push buttons and slide switches to MPN and footprints
    [capsicum.kicad_sch]
2023-12-07 feat: associate screw terminal part
    [capsicum.kicad_sch]
2023-12-07 feat: associate USB-C through-hole 16+8 USB2.0 connector footprint
    [capsicum.kicad_sch]
2023-12-08 feat: add resistors to combined D+ D-
    [capsicum.kicad_sch]
2023-12-08 feat: add test points and bridged jumpers
    [capsicum.kicad_sch]
2023-12-10 feat: associate MPN and BOM details to battery monitoring circuit MOSFET
    [capsicum.kicad_sch]
2023-12-10 docs: add links on low power batt measurement circuit
2023-12-11 docs: change URL for buying the wired doorbell
2023-12-11 chore: gitignore all files starting with # like KiCad's #auto_saved_files#
2023-12-12 feat: associate MPN and BOM details for orange LED in charging circuit
    [capsicum.kicad_sch]
2023-12-12 feat: associate MPN and BOM details for yellow LED in charging circuit
    [capsicum.kicad_sch]
2023-12-12 feat: associate MPN and BOM details for red LED in charging circuit
    [capsicum.kicad_sch]
2023-12-12 feat: associate MPN and BOM details for Schottky diode
    [capsicum.kicad_sch]
2023-12-12 feat: associate MPN and BOM details for some resistor values
    [capsicum.kicad_sch]
2023-12-14 feat: associate MPN and BOM details for all resistors
    [capsicum.kicad_sch]
2023-12-14 refactor: udpate bell ding dong chip to integrate the speaker
    [capsicum.kicad_sch]
2023-12-14 feat: associate footprint for 16230 battery
    [capsicum.kicad_sch]
2023-12-15 feat: publish bill of materials
    [bill_of_materials.csv, capsicum.kicad_sch]
2023-12-25 feat: add right-angled header pin connector for the bell
    [capsicum.kicad_sch]
2023-12-25 feat: add 2 capacitors to 3.3V of the MCU
    [bill_of_materials.csv, capsicum.kicad_sch]
2023-12-25 fix: fix bom cost code
    [bill_of_materials.csv]
2023-12-27 feat: create the initial layout with assigned 3D models
    [capsicum.kicad_pcb, capsicum.kicad_sch]
2023-12-27 feat: reorient all text to face upright on silkscreen layer
    [capsicum.kicad_pcb]
2023-12-30 feat: group components in the logic block USB-C, battery and charger
    [capsicum.kicad_pcb]
2023-12-30 feat: group components from batt measurement logical block in layout
    [capsicum.kicad_pcb]
2023-12-30 feat: group components from reset mcu logical block in layout
    [capsicum.kicad_pcb]
2023-12-30 feat: group components from LDO logical block in layout
    [capsicum.kicad_pcb, capsicum.kicad_sch]
2023-12-30 feat: group components from power LEDs logical block in layout
    [capsicum.kicad_pcb]
2023-12-30 feat: group components from TX/RX/Status LEDs logical block in layout
    [capsicum.kicad_pcb]
2023-12-30 feat: group components from sleep-check logical block in layout
    [capsicum.kicad_pcb]
2023-12-30 feat: group components from bell logical block in layout
    [capsicum.kicad_pcb, capsicum.kicad_sch]
2023-12-30 feat: group components from bell connector logical block in layout
    [capsicum.kicad_pcb]
2023-12-30 feat: group components from mcu logical block in layout
    [capsicum.kicad_pcb, capsicum.kicad_sch]
2023-12-31 feat: update layout, schematic and BOM with new test point for ground
    [bill_of_materials.csv, capsicum.kicad_pcb, capsicum.kicad_sch]
2024-01-01 feat: add boot mode button in schematic, layout, BOM
    [bill_of_materials.csv, capsicum.kicad_pcb, capsicum.kicad_sch]
2024-01-01 feat: replace 3x open jumpers with solderless option of header pins for jumper caps
    [bill_of_materials.csv, capsicum.kicad_pcb, capsicum.kicad_sch]
2024-01-02 refactor: put all LEDs together and shorten the board
    [capsicum.kicad_pcb, capsicum.kicad_sch]
2024-01-03 feat: add silkscreen text about project
    [capsicum.kicad_pcb]
2024-01-03 docs: add notes for snap-fit 3d printed enclosures
2024-01-04 feat: create FreeCAD spreadsheet
    [case.FCStd]
2024-01-04 feat: place components for case groves-teeth and mounting holes
    [capsicum.kicad_pcb]
2024-01-04 feat: fix on-off switch direction and change sleep switch to top control
    [capsicum.kicad_pcb, capsicum.kicad_sch]
2024-01-05 feat: add C&K Slide switch SPDT 3D model and footprint
    [bill_of_materials.csv, capsicum.kicad_pcb, capsicum.kicad_sch]
2024-01-09 feat: add PCB lenghth, width, extension measurements to spreadsheet CAD
    [case.FCStd]
2024-01-09 feat: add grid origin and pcb dimensions in User.Drawings layer
    [capsicum.kicad_pcb]
2024-01-19 feat: load KiCad PCB into FreeCAD with KiCadStepUp
    [case.FCStd]
2024-01-23 feat: import KiCAD PCB into FreeCAD
    [case.FCStd]
2024-01-23 fix: reimport bill of materials
    [bill_of_materials.csv]
2024-01-23 fix: remove long DNP in BOM
    [bill_of_materials.csv]
2024-01-23 feat: make a cuboid to house the pcb
    [case.FCStd]
2024-01-23 feat: cut an inner box with wall thickness 2mm
    [case.FCStd]
2024-01-23 feat: cut connector and LED slots
    [capsicum.kicad_pcb, case.FCStd]
2024-01-24 refactor: enlarge connector slots
    [case.FCStd]
2024-01-24 refactor: reduce LED slot width
    [capsicum.kicad_pcb]
2024-01-24 feat: add 2x battery holder supports
    [capsicum.kicad_pcb, case.FCStd]
2024-01-24 feat: add 4x screw supports
    [capsicum.kicad_pcb, case.FCStd]
2024-01-24 feat: cut ventilation holes at the bottom of the case
    [case.FCStd]
2024-01-24 feat: fix ventilation hole cut operation
    [case.FCStd]
2024-01-25 feat: fuse round speaker base
    [case.FCStd]
2024-01-25 feat: cut speaker slots
    [case.FCStd]
2024-01-25 feat: add battery 3D model to battery holder
    [capsicum.kicad_pcb]
2024-01-25 fix: change battery holder height to include battery
    [case.FCStd]
2024-01-25 feat: integrate speaker 3D Model and STL exports
    [capsicum.kicad_pcb, case.FCStd, case.stl]
2024-01-25 feat: create a seperation plane
    [case.FCStd]
2024-01-25 feat: create a seperation plane to avoid the protruding screw supports
    [case.FCStd]
2024-01-25 feat: split case into top and bottom parts
    [bottom.stl, case.stl, top.stl]
2024-01-25 refactor: move the speaker plot higher up to not clash with ESP32C3 board
    [case.FCStd]
2024-01-25 feat: add one teeth body
    [case.FCStd]
2024-01-26 feat: add 4x teeth
    [case.FCStd]
2024-01-26 feat: add 4x grooves
    [case.FCStd]
2024-01-26 feat: fuse 4x teeth to the bottom and 4x grooves to the top
    [case.FCStd]
2024-01-26 refactor: change board shape to make way for teeth and groove
    [capsicum.kicad_pcb]
2024-01-26 refactor: export new board shape into CAD to accomodate teeth-groove
    [bottom.stl, case.FCStd, case.stl, top.stl]
2024-01-26 refactor: move LEDs, USB-C and Screw terminal connectors in PCB layout
    [capsicum.kicad_pcb, capsicum.kicad_sch]
2024-01-30 refactor: move screw terminal and USB-C connectors
    [capsicum.kicad_pcb, case.FCStd]
2024-01-30 refactor: move LED slot
    [bottom.stl, capsicum.kicad_pcb, case.FCStd, case.stl, top.stl]
2024-01-30 refactor: update all measurement labels in KiCAD with labels from FreeCAD
    [capsicum.kicad_pcb, case.FCStd]
2024-01-31 feat: drop power fill zones on top and bottom layers [119 unconnected]
    [capsicum.kicad_pcb]
2024-01-31 fix: connect USB-C A5 to resistor and ground [114 unconnected]
    [capsicum.kicad_pcb, capsicum.kicad_sch]
2024-01-31 feat: add traces to battery logic block [110 unconected]
    [capsicum.kicad_pcb]
2024-01-31 feat: add traces to charger logic block [96 unconnected]
    [capsicum.kicad_pcb]
2024-01-31 feat: add traces to LDO logic block [84 unconnected]
    [capsicum.kicad_pcb, capsicum.kicad_sch]
2024-01-31 feat: add traces to batt measurement logic block [75 unconnected]
    [capsicum.kicad_pcb]
2024-01-31 feat: add traces to reset button logic block [66 unconnected]
    [capsicum.kicad_pcb]
2024-01-31 feat: add traces to LED logic blocks [54 unconnected]
    [capsicum.kicad_pcb]
2024-01-31 feat: add traces to sleep check logic block [52 unconnected]
    [capsicum.kicad_pcb]
2024-01-31 feat: add traces to bell audio logic block [49 unconnected]
    [capsicum.kicad_pcb]
2024-01-31 feat: add traces to boot button logic block [45 unconnected]
    [capsicum.kicad_pcb]
2024-01-31 feat: add traces to bell logic block [40 unconnected]
    [capsicum.kicad_pcb]
2024-01-31 docs: export new layout and schematic
    [capsicum.kicad_pcb]
2024-01-31 refactor: change pcb thickness to 1.6mm in CAD design
    [case.FCStd]
2024-01-31 refactor: move notes in back silkscreen
    [capsicum.kicad_pcb]
2024-01-31 feat: add more traces [27 unconnected
    [capsicum.kicad_pcb]
2024-02-01 refactor: move LED slot and import pcb in FreeCAD
    [capsicum.kicad_pcb, case.FCStd]
2024-02-01 feat: connect all traces to USB-C J3 connector [17 unconnected]
    [capsicum.kicad_pcb, capsicum.kicad_sch]
2024-02-01 feat: connect all power unconnected power zones [12 unconnected]
    [capsicum.kicad_pcb]
2024-02-01 feat: connect more traces [3 unconnected]
    [capsicum.kicad_pcb]
2024-02-01 feat: connect more traces [1 unconnected]
    [capsicum.kicad_pcb]
2024-02-01 feat: connect all traces [0 unconnected]
    [capsicum.kicad_pcb]
2024-02-01 docs: update all images and exports
    [bottom.stl, capsicum.kicad_pcb, capsicum.kicad_sch, case.FCStd, case.stl, top.stl]
2024-02-02 feat: add project name and LED text
2024-02-02 feat: add ON OFF text at the side of the case
2024-02-02 docs: export images and STL files
    [case.stl, top.stl]
2024-02-06 refactor: rotate USB-C in schematic to point GND bottom and 5V top
    [capsicum.kicad_sch]
2024-02-06 refactor: rename 5V to VUSB
    [capsicum.kicad_pcb, capsicum.kicad_sch]
2024-02-08 docs: regenerate all docs after adding new capacitor and VUSB label
    [bill_of_materials.csv, bottom.stl, capsicum.kicad_pcb, capsicum.kicad_sch, case.stl, top.stl]
2024-02-16 docs: add case width and length distances in FreeCAD
2024-02-16 feat: add a wall hook slot at the bottom of the case
    [bottom.stl, case.stl, top.stl]
2024-02-16 refactor: move silkscreen Notes and Install Date to a position that is wrtable
    [capsicum.kicad_pcb]
2024-02-19 refactor: update debug message to print the length of bell timeout
2024-02-20 refactor: update case to have white plastic finishing
2024-02-26 feat: add bom-uniq-th, bom-uniq-dnp, and bom-uniq-smt to bom.json
2024-02-26 fix: add SMD for all 3 push buttons in BOM
    [capsicum.kicad_sch]
2024-02-26 fix: add missing vendor name in BOM for PCB Assembly
    [capsicum.kicad_sch]
2024-02-27 fix: change to DigiKey parts URL
    [bill_of_materials.csv, capsicum.kicad_sch]
2024-02-27 fix: change all LED and diode to the correct footprint with polarity markings
    [capsicum.kicad_pcb, capsicum.kicad_sch]
2024-02-27 chore: generate Gerbers for manufacturing
    [capsicum.kicad_pcb]
2024-02-27 docs: link to generated gerbers
2024-02-29 docs: add build time manufacturing param for PCB
2024-02-29 chore: update submodule to seperate case page into sections
2024-02-29 docs: add manufacturing params for case
2024-02-29 docs: add specific MPN for ESP32-C3
    [bill_of_materials.csv, capsicum.kicad_pcb, capsicum.kicad_sch]
2024-03-04 feat: display all prototype images until defined max_prototype_images
2024-03-04 fix: add check for an extra empty empty image slot only if there are odd images
2024-03-13 feat: add interactive HTML BOM
2024-03-13 docs: add a total cost breakdown section
    [cost.csv]
2024-03-15 feat: add software bill of materials
    [sbom.csv]
2024-03-15 fix: update all LED footprint to diode instead of resistor in BOM
    [bill_of_materials.csv]
2024-03-17 docs: add RGB LED for V2 and update submodule
2024-03-20 docs: add V2 iteration improvements on a better quality slide switch
2024-03-25 docs: add resources to flash a raw ESP32-C3-WROOM-02
2024-03-25 fix: change pin 3 on RST and BOOT buttons to unconnected
    [capsicum.kicad_pcb, capsicum.kicad_sch]
2024-03-27 docs: generate schematic and layout for V1.0.1
    [capsicum.kicad_pcb, capsicum.kicad_sch]
2024-03-27 feat: add blinky code for PCB
2024-03-28 fix: enable serial prints with CDC on Boot enabled option
2024-03-29 fix: display the name of manufacturer in BOM
    [bill_of_materials.csv]
2024-04-01 feat: add demo breadboard and demo PCB code
2024-04-01 docs: add images of manufactured case and pcb
2024-04-01 feat: add a section on photos of manufactured PCBs
2024-04-01 feat: update submodules to display manufactured PCB photos
2024-04-04 docs: add power consumption measurement instructions for blinky example
2024-04-06 docs: add power consumption notes without any optimisation
2024-04-06 refactor (firmware): add power consumption optimisation code
2024-04-09 docs: add power consumption measurement file downloads
2024-04-09 fix: update download links for power consumption measurement files
2024-04-09 docs (firmware): add todo tasks for battery level calculation and send to Zapier
2024-04-09 feat (firmware): add battery level calculation and send to Zapier
2024-04-09 docs: fix typo in comment for sending to Zapier in production environment
    [demo.ino]
2024-04-09 fix: refactor battery level calculation to percentage
    [batteryLevel.cpp]
2024-04-10 docs (firmware): add a todo to fix the calculation of the battery level
    [batteryLevel.cpp]
2024-04-11 feat: add a new power page
2024-04-11 docs (power): update power consumption information
2024-04-11 feat: add tutorial on setting up an access point to eventually display the batt voltage
2024-04-11 refactor (firmware): simplify web server client for reading batt voltage
2024-04-11 docs (firmware): Add a fix note for battery measurement pin
    [measure-battery-level.ino]
2024-04-12 refactor: add an LED indication when displaying the battery voltage on webpage
2024-04-12 docs (power): add falstad battery measurement circuit simulation
2024-04-12 fix: change datasheet link for p-channel mosfet NTS2101P
    [bill_of_materials.csv, capsicum.kicad_sch]
2024-04-12 docs (power): add resistors in falstad simulation
2024-04-15 docs (power): add resistors 100k in simulation for batt measurement
2024-04-15 docs (firmware): BATTERY_ENABLE_PIN does not change in HIGH or LOW state
2024-04-15 docs (power): update link to web archive
2024-05-01 chore: update submodules to sync BOM stats with the manufacturer
2024-06-14 docs: add mistake-proof assembly design for case and PCB
2024-06-15 docs: add todo task for blinking LED for low battery level
2024-06-18 fix: turn on and off adc battery enable pin
    [measure-battery-level.ino]
2024-06-19 fix (firmware): remove unnecessary delay in loop function to measure batt level
    [measure-battery-level.ino]
2024-06-19 refactor (firmware): rename variable and turn on MOSFET immediately before analog measurement
2024-06-19 feat (firmware): add battery level percentage value
2024-06-19 refactor (firmware): remove unused serial print in access point code example
2024-06-23 docs (power): add links to battery measurement circuit and code
2024-06-26 docs (firmware): add prototype image for access point tutorial code
2024-07-09 fix (firmware, schematic, layout): change vref for adc and resistors to measure battery voltage
    [capsicum.kicad_pcb, capsicum.kicad_sch]
2024-07-09 fix (firmware): change comment on 2.8V reference voltage
    [measure-battery-level.ino]
2024-07-09 refactor (firmware): increase the accuracy of Vref to 2.86V
2024-07-10 fix (bom): change R9 and R10 to 100k for the battery measurement circuit
    [bill_of_materials.csv, capsicum.kicad_pcb]
2024-07-11 docs (firmware): add oscilloscope screenshots for measuring batt voltage
2024-07-12 feat (firmware): update battery level calculation and pin assignments
2024-07-12 docs (schematic): update image
2024-10-11 feat: blink the LED 10x if battery level is below 20%
2024-11-02 feat (prototype): Add example for testing retrofit of doorbell with only breadboard and PSU
2024-11-13 feat (firmware): add tutorial on using minimum code with dev board and breadboard
2024-11-13 refactor (firmware): remove the print wakeup reason function to make the code even more minimal
2024-11-14 chore: update submodule to conditionally display edit button
2024-11-14 feat: add user labels for buttons and power connections in PCB and schematic
    [capsicum.kicad_pcb, capsicum.kicad_sch]
2024-11-14 feat: update Makefile and code for PCB and breadboard configurations
2024-11-15 feat (firmware): update LEDController to support customizable blink period
2024-11-15 fix: update debug message to reflect bell mute status and correct environment variable assignment
    [demo.ino]
2024-11-18 fix (firmware): ensure batt level is sent to the post hook
    [demo.ino, timeManager.cpp]
2024-11-18 fix (firmware): fix 4s delay in sounding the bell in production
    [demo.ino]
2024-12-04 feat (firmware): add demo code for measuring raw ADC value on ESP32-C3
2024-12-04 refactor (firmware): simplify battery voltage calculation to use voltage divider ratio of 0.5
2024-12-05 fix (firmware): initialize LED controller before blinking for low battery warning
    [demo.ino]
2024-12-05 fix (firmware): reduce low battery blink period to 250ms and adjust delay logic
    [demo.ino]
2024-12-06 refactor (firmware): update debug levels and enhance logging for time management and battery alerts
2024-12-06 feat (firmware): add simulation flags for WiFi and battery status
2024-12-07 fix (firmware): correct voltage divider ratio in battery voltage calculation
    [measure-battery-level.ino]
2024-12-11 chore: generate updated schematic, layout, iBOM
    [capsicum.kicad_pcb, capsicum.kicad_sch]
2024-12-11 chore: add updated schematic
    [capsicum.kicad_sch]
2024-12-13 fix (documentation): update lessons for layout, case, and firmware improvements
2024-12-13 docs (power): update battery source capacity and add charging setup instructions
2024-12-24 chore: update kicad and scripts
    [capsicum.kicad_sch]
