hutscape/capsicum/(notices)

Notices in the files:
pcb/capsicum.kicad_sch:
License: CC-BY-SA 4.0 or TAPR
